CircuitMonkey/mos-kim1-replica/README.md

# mos-kim1-replica
MOS KIM-1 6502 replica project using CHIPz modules.
