CircuitMonkey/mos-kim1-replica/assets/mos-logo.pdf

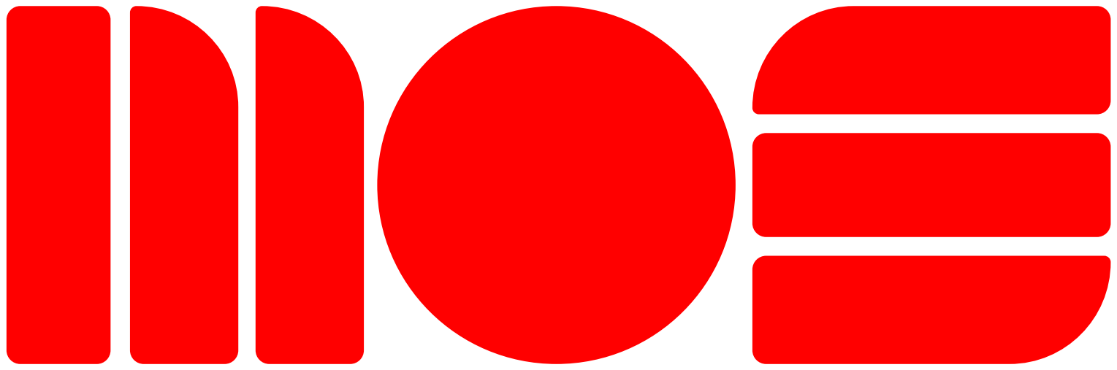
[picture p1: page 1]
