CircuitMonkey/mos-kim1-replica/documents/mainboard/kim-1000-mainboard-rev-a-bom.ods

Reference | Qty | Value | Have | Mouser | MPN | Footprint | Datasheet
C1,C2,C3,C4,C5 | 5 | 0.1uF |  |  |  | Capacitor_SMD:C_0603_1608Metric | ~
D1,D2,D3,D4,D5,D6,D7,D8,D9,D10,D11,D12,D13,D14,D15,D16,D17,D18,D19,D20,D21,D22,D23,D24,D25,D26,D27,D28,D29,D30,D31,D32,D33,D34,D35,D36,D37,D38,D39,D40 | 40 | BLU |  |  |  | LED_SMD:LED_0603_1608Metric | ~
J1 | 1 | Expansion |  |  |  | Connector_Expansion:Expansion
J2 | 1 | Application |  |  |  | Connector_Expansion:Expansion
J3 | 1 | USB_C_Recpt_PO_6P |  |  | UJCHGSMT2P6 | Connector_USB:USB_C_Receptacle_HRO_TYPE-C-31-M-17 | https://www.usb.org/sites/default/files/documents/usb_type-c.zip
R1,R2,R3,R4,R5,R6,R7,R8,R9,R10,R11,R12,R13,R14,R15,R16,R17,R18,R19,R20,R21,R22,R23,R24,R25,R26,R27,R28,R29,R30,R31,R32,R33,R34,R35,R36,R37,R38,R39,R40 | 40 | 100 |  |  |  | Resistor_SMD:R_0603_1608Metric | ~
R50 | 1 | 10K |  |  |  | Resistor_SMD:R_0603_1608Metric | ~
R51,R52 | 2 | 5.1K |  |  |  | Resistor_SMD:R_0603_1608Metric | ~
U1 | 1 | 65C816 |  |  |  | CM_CHIPz_Modules:CPU_65C816_Module
U2 | 1 | Control |  |  |  | CM_CHIPz_Modules:KIM1-Control-CHIPz-Module
U3 | 1 | Keyboard & Display |  |  |  | CM_CHIPz_Modules:KIM1-Kbd-Display-Module
U4,U5 | 2 | 6530 RIOT |  |  |  | CM_CHIPz_Modules:IO_6530_RIOT
U6 | 1 | SRAM 32Kx8 |  |  |  | CM_CHIPz_Modules:KIM1-CHIPz-SRAM-32Kx8
U7,U10,U11,U12 | 4 | 74LV540 |  |  | SN74LV540ARGY | CM_Chip_Packages:TI_RGY0020A-VQFN-20-Pad_3.5x4.5mm | http://www.ti.com/lit/gpn/sn74LS540
U13 | 1 | 74LV541 |  |  | SN74LV541ARKS | CM_Chip_Packages:TI_RKS0020B-VQFN-20-Pad_2.5x4.5mm | http://www.ti.com/lit/gpn/sn74LS541
U14 | 1 | #0131 |  |  |  | CM_CHIPz_Modules:0131-DC-DC-3A
