CircuitMonkey/mos-kim1-replica/documents/control-module/control-logic-module-bom.ods

MOS-KIM-1000 Control Module |  |  | Rev. A
Reference | Qty | Value | Footprint | Have | Datasheet
C1,C6,C7 | 3 | 0.1uF | Capacitor_SMD:C_0603_1608Metric |  | ~
C2 | 1 | 4.7uF | Capacitor_SMD:C_0603_1608Metric |  | ~
C3 | 1 | 0.01uF | Capacitor_SMD:C_0603_1608Metric |  | ~
C4,C5 | 2 | 0.22uF | Capacitor_SMD:C_0603_1608Metric | Mouser | ~
R1,R2,R3,R4,R5,R8,R9,R10,R11 | 9 | 3.3K | Resistor_SMD:R_0603_1608Metric |  | ~
R6,R7 | 2 | 1K | Resistor_SMD:R_0603_1608Metric |  | ~
R12,R13 | 2 | 47K | Resistor_SMD:R_0603_1608Metric |  | ~
U1 | 1 | 74HC04 | CM_Chip_Packages:QFN-14_EP_2.5x3_Pitch0.5mm | Mouser | https://assets.nexperia.com/documents/data-sheet/74HC_HCT04.pdf
U2,U3 | 2 | 74AHC1G00 | Package_TO_SOT_SMD:SOT-353_SC-70-5 | Mouser | http://www.ti.com/lit/sg/scyt129e/scyt129e.pdf
U4 | 1 | TLC556 | Package_SO:SO-14_3.9x8.65mm_P1.27mm | Mouser | https://www.ti.com/lit/ds/symlink/tlc556.pdf?ts=1752791576303
U5 | 1 | 74LS145 | Package_SO:SO-16_3.9x9.9mm_P1.27mm | Mouser | http://www.ti.com/lit/gpn/sn74LS145
Y1 | 1 | 8MHz | Oscillator:Oscillator_SMD_Abracon_ASDMB-4Pin_2.5x2.0mm | Mouser | https://abracon.com/Oscillators/ASDMB.pdf
