CircuitMonkey/mos-kim1-replica/documents/kbd-display-module/kbd-display-module-bom.ods

MOS KIM-1000 Keyboard&Display |  |  |  | Rev. A
Reference | Qty | Value | Have | Footprint | Datasheet
C1,C2 | 2 | 0.1uF |  | Capacitor_SMD:C_0603_1608Metric | ~
D1 | 1 | BLUE |  | LED_SMD:LED_0603_1608Metric | ~
Q1,Q2,Q3,Q4,Q5,Q6 | 6 | MMBT3906 | Mouser | Package_TO_SOT_SMD:SOT-23 | https://www.onsemi.com/pdf/datasheet/pzt3906-d.pdf
R1,R2,R3,R4,R5,R6 | 6 | 470 |  | Resistor_SMD:R_0603_1608Metric | ~
R7,R8,R9,R10,R11,R12 | 6 | 100K |  | Resistor_SMD:R_0603_1608Metric | ~
R13,R14,R15,R16,R17,R18,R19,R20 | 8 | 100 |  | Resistor_SMD:R_0603_1608Metric | ~
SW1 | 1 | BTN_0 | Zodiac | CM_Switches:Tactile_CK_KSC_6x6_Gullwing | https://www.taydaelectronics.com/tact-switch-6-3-6-6mm-3-1mm-smd-spst-no.html
SW2 | 1 | BTN_1 |  | CM_Switches:Tactile_CK_KSC_6x6_Gullwing | https://www.taydaelectronics.com/tact-switch-6-3-6-6mm-3-1mm-smd-spst-no.html
SW3 | 1 | BTN_2 |  | CM_Switches:Tactile_CK_KSC_6x6_Gullwing | https://www.taydaelectronics.com/tact-switch-6-3-6-6mm-3-1mm-smd-spst-no.html
SW4 | 1 | BTN_3 |  | CM_Switches:Tactile_CK_KSC_6x6_Gullwing | https://www.taydaelectronics.com/tact-switch-6-3-6-6mm-3-1mm-smd-spst-no.html
SW5 | 1 | BTN_4 |  | CM_Switches:Tactile_CK_KSC_6x6_Gullwing | https://www.taydaelectronics.com/tact-switch-6-3-6-6mm-3-1mm-smd-spst-no.html
SW6 | 1 | BTN_5 |  | CM_Switches:Tactile_CK_KSC_6x6_Gullwing | https://www.taydaelectronics.com/tact-switch-6-3-6-6mm-3-1mm-smd-spst-no.html
SW7 | 1 | BTN_6 |  | CM_Switches:Tactile_CK_KSC_6x6_Gullwing | https://www.taydaelectronics.com/tact-switch-6-3-6-6mm-3-1mm-smd-spst-no.html
SW8 | 1 | BTN_7 |  | CM_Switches:Tactile_CK_KSC_6x6_Gullwing | https://www.taydaelectronics.com/tact-switch-6-3-6-6mm-3-1mm-smd-spst-no.html
SW9 | 1 | BTN_8 |  | CM_Switches:Tactile_CK_KSC_6x6_Gullwing | https://www.taydaelectronics.com/tact-switch-6-3-6-6mm-3-1mm-smd-spst-no.html
SW10 | 1 | BTN_9 |  | CM_Switches:Tactile_CK_KSC_6x6_Gullwing | https://www.taydaelectronics.com/tact-switch-6-3-6-6mm-3-1mm-smd-spst-no.html
SW11 | 1 | BTN_A |  | CM_Switches:Tactile_CK_KSC_6x6_Gullwing | https://www.taydaelectronics.com/tact-switch-6-3-6-6mm-3-1mm-smd-spst-no.html
SW12 | 1 | BTN_B |  | CM_Switches:Tactile_CK_KSC_6x6_Gullwing | https://www.taydaelectronics.com/tact-switch-6-3-6-6mm-3-1mm-smd-spst-no.html
SW13 | 1 | BTN_C |  | CM_Switches:Tactile_CK_KSC_6x6_Gullwing | https://www.taydaelectronics.com/tact-switch-6-3-6-6mm-3-1mm-smd-spst-no.html
SW14 | 1 | BTN_D |  | CM_Switches:Tactile_CK_KSC_6x6_Gullwing | https://www.taydaelectronics.com/tact-switch-6-3-6-6mm-3-1mm-smd-spst-no.html
SW15 | 1 | BTN_E |  | CM_Switches:Tactile_CK_KSC_6x6_Gullwing | https://www.taydaelectronics.com/tact-switch-6-3-6-6mm-3-1mm-smd-spst-no.html
SW16 | 1 | BTN_F |  | CM_Switches:Tactile_CK_KSC_6x6_Gullwing | https://www.taydaelectronics.com/tact-switch-6-3-6-6mm-3-1mm-smd-spst-no.html
SW17 | 1 | BTN_AD |  | CM_Switches:Tactile_CK_KSC_6x6_Gullwing | https://www.taydaelectronics.com/tact-switch-6-3-6-6mm-3-1mm-smd-spst-no.html
SW18 | 1 | BTN_DA |  | CM_Switches:Tactile_CK_KSC_6x6_Gullwing | https://www.taydaelectronics.com/tact-switch-6-3-6-6mm-3-1mm-smd-spst-no.html
SW19 | 1 | BTN_PLUS |  | CM_Switches:Tactile_CK_KSC_6x6_Gullwing | https://www.taydaelectronics.com/tact-switch-6-3-6-6mm-3-1mm-smd-spst-no.html
SW20 | 1 | BTN_GO |  | CM_Switches:Tactile_CK_KSC_6x6_Gullwing | https://www.taydaelectronics.com/tact-switch-6-3-6-6mm-3-1mm-smd-spst-no.html
SW21 | 1 | BTN_PC |  | CM_Switches:Tactile_CK_KSC_6x6_Gullwing | https://www.taydaelectronics.com/tact-switch-6-3-6-6mm-3-1mm-smd-spst-no.html
SW22 | 1 | BTN_RS |  | CM_Switches:Tactile_CK_KSC_6x6_Gullwing | https://www.taydaelectronics.com/tact-switch-6-3-6-6mm-3-1mm-smd-spst-no.html
SW23 | 1 | BTN_ST |  | CM_Switches:Tactile_CK_KSC_6x6_Gullwing | https://www.taydaelectronics.com/tact-switch-6-3-6-6mm-3-1mm-smd-spst-no.html
SW24 | 1 | Single-Step | Mouser | CM_Switches:CK_JS202011SC_SLIDE_DPDT_SMT_9x3.6
U1 | 1 | 74HC42 | Mouser | Package_SO:SO-16_3.9x9.9mm_P1.27mm | http://www.ti.com/lit/gpn/sn74HC42
U2 | 1 | Color |  | CM_Display_Character:Avago-HDSM-281x-283x-SevenSeg | https://docs.broadcom.com/doc/HDSM-281x-283x-0-28-in-Single-Digit-SMT-LED-Display-DS
U3,U4,U5,U6,U7 | 5 | BLUE |  | CM_Display_Character:Avago-HDSM-281x-283x-SevenSeg | https://docs.broadcom.com/doc/HDSM-281x-283x-0-28-in-Single-Digit-SMT-LED-Display-DS
U8 | 1 | 74LVC06 | Mouser | Package_SO:SOIC-14_3.9x8.7mm_P1.27mm | https://assets.nexperia.com/documents/data-sheet/74LVC06A.pdf
U9 | 1 | 74LVC1G06Z | Mouser | CM_Chip_Packages:SOT-353 | http://www.ti.com/lit/sg/scyt129e/scyt129e.pdf
