CircuitMonkey/mos-kim1-replica/documents/sram-module/sram-32kx8-module-bom.ods

KIM-1000 SRAM Module |  |  | Rev. A
Reference | Qty | Value | Footprint | Have | Datasheet
C1,C2 | 2 | 0.1uF | Capacitor_SMD:C_0603_1608Metric |  | ~
U1 | 1 | 74LV20 | Package_SO:SOIC-14_3.9x8.7mm_P1.27mm | Mouser | http://www.ti.com/lit/gpn/sn74LS20
U2 | 1 | 74AHC1G00 | Package_TO_SOT_SMD:SOT-353_SC-70-5 | Mouser | http://www.ti.com/lit/sg/scyt129e/scyt129e.pdf
U3 | 1 | 62LV256AL45ULI | CM_Chip_Packages:SOIC-28_18x9 | Mouser | https://www.mouser.com/datasheet/2/198/62_65LV256AL-258445.pdf
