CircuitMonkey/mos-kim1-replica/pcb/sram-32kx8-module/sram-32kx8-module.step

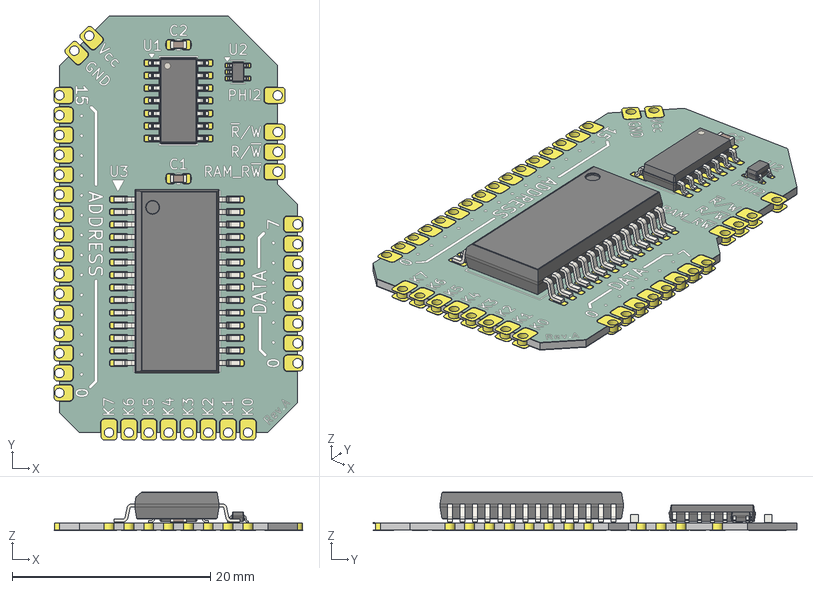
[picture p2: CAD file, 2025-07-27]
pcb/sram-32kx8-module/sram-32kx8-module.step
25.1 x 42.8 x 3.92 mm
SOT-353_SC-70-5
SOIC-14_3.9x8.7mm_P1.27mm
sop-28-330mil
C_0603_1608Metric x 2
sram-32kx8-module_copper
sram-32kx8-module_silkscreen
sram-32kx8-module_soldermask
sram-32kx8-module_PCB
