CircuitMonkey/mos-kim1-replica/documents/mainboard/kim-1000-mainboard-rev-a-schematic.pdf

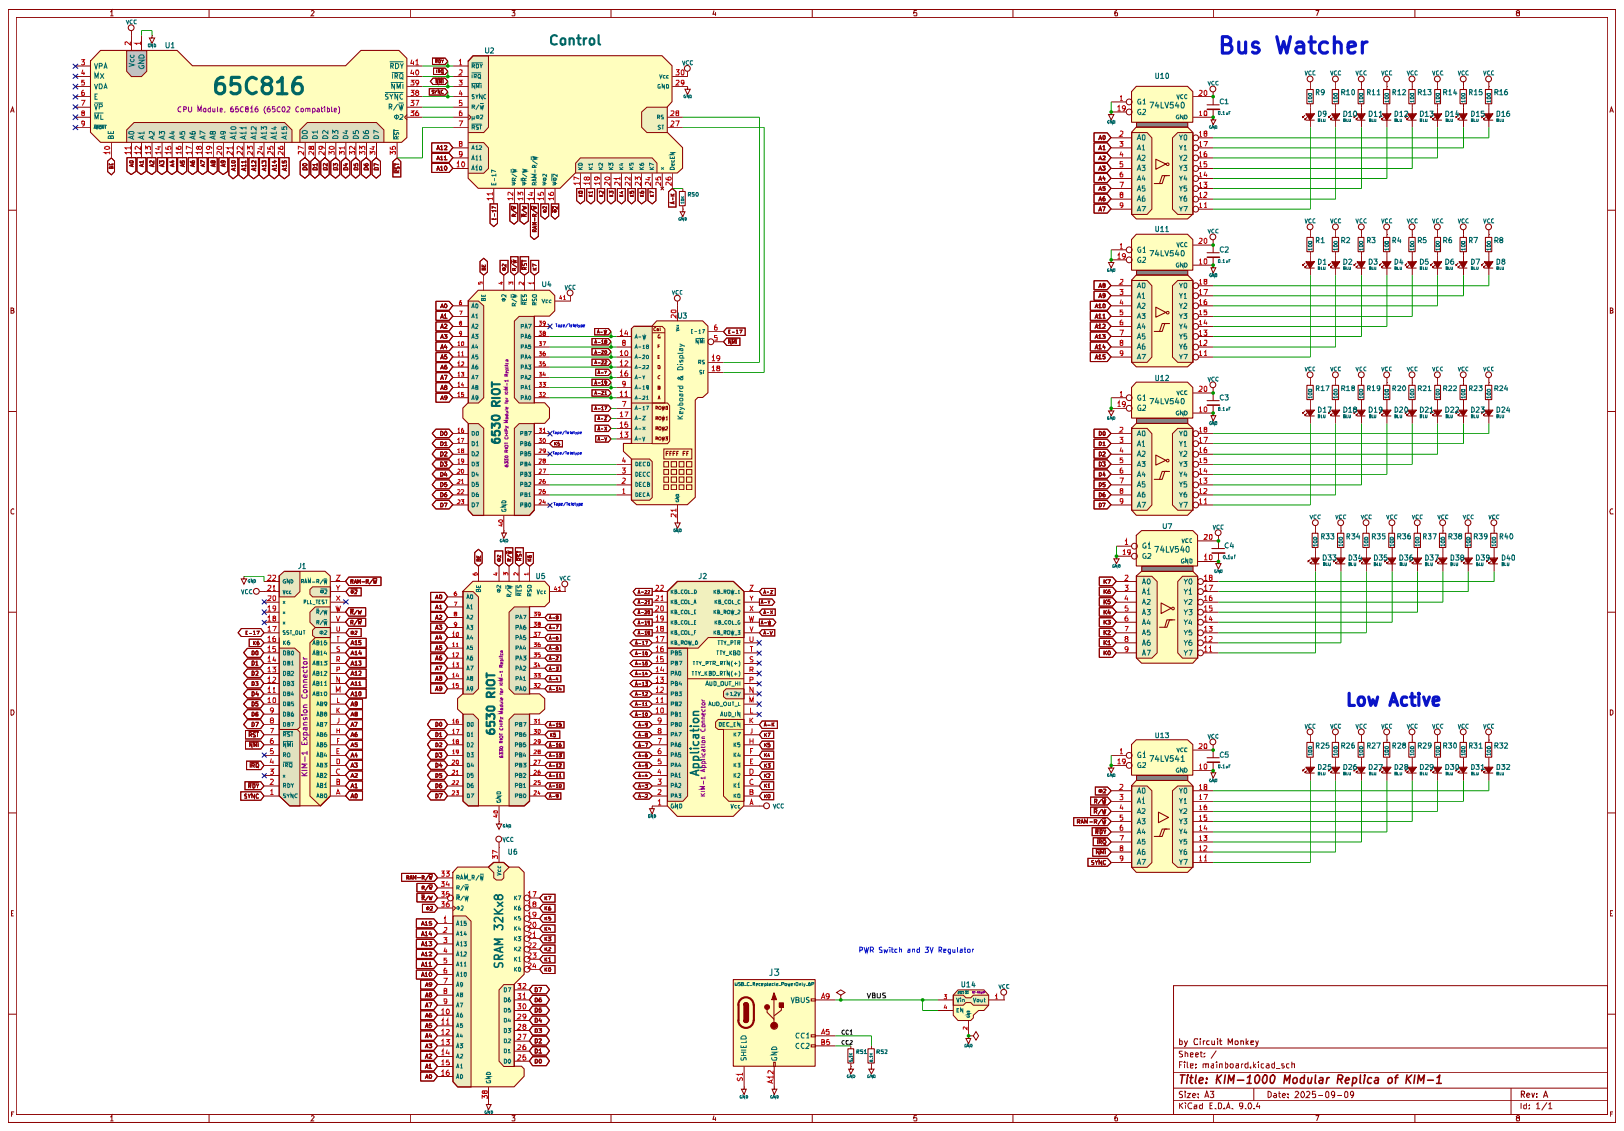
[picture p3: page 1]
