CircuitMonkey/mos-kim1-replica/documents/control-module/control-logic-module-rev-b-sch.pdf

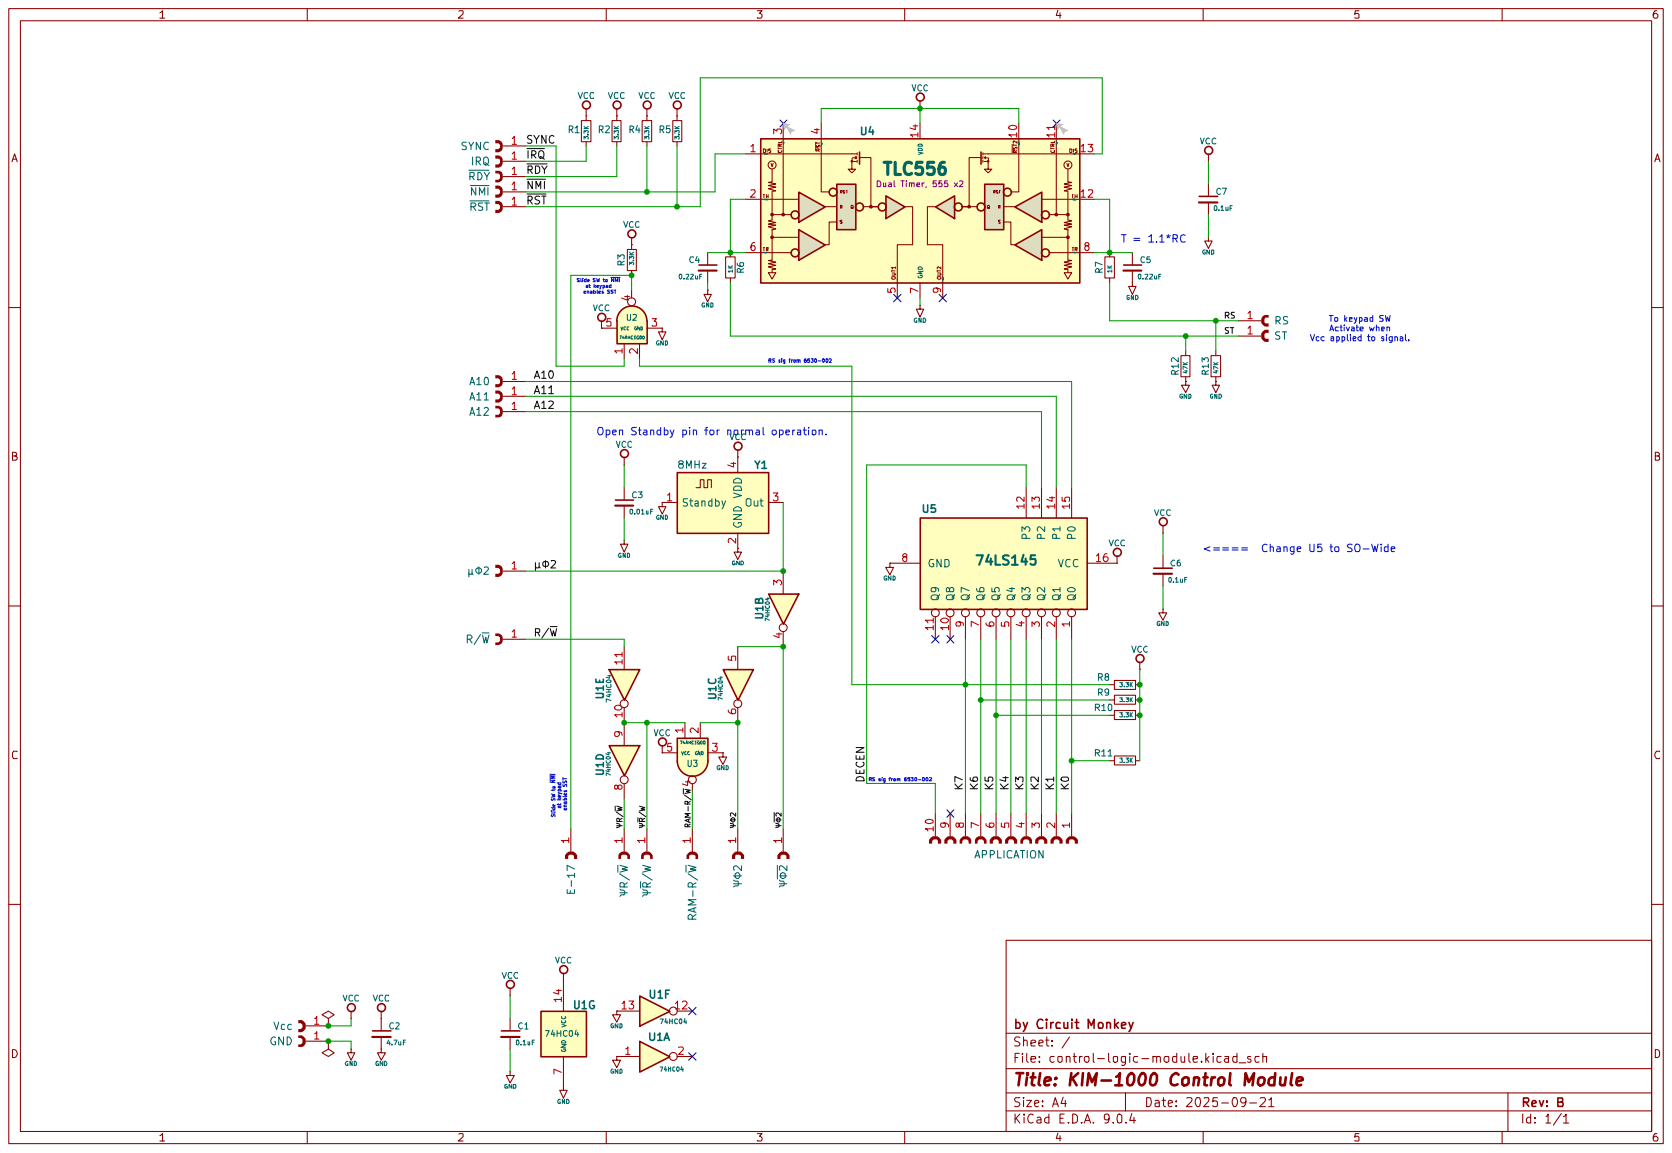
[picture p4: page 1]
