CircuitMonkey/mos-kim1-replica/documents/sram-module/sram-32kx8-module-sch.pdf

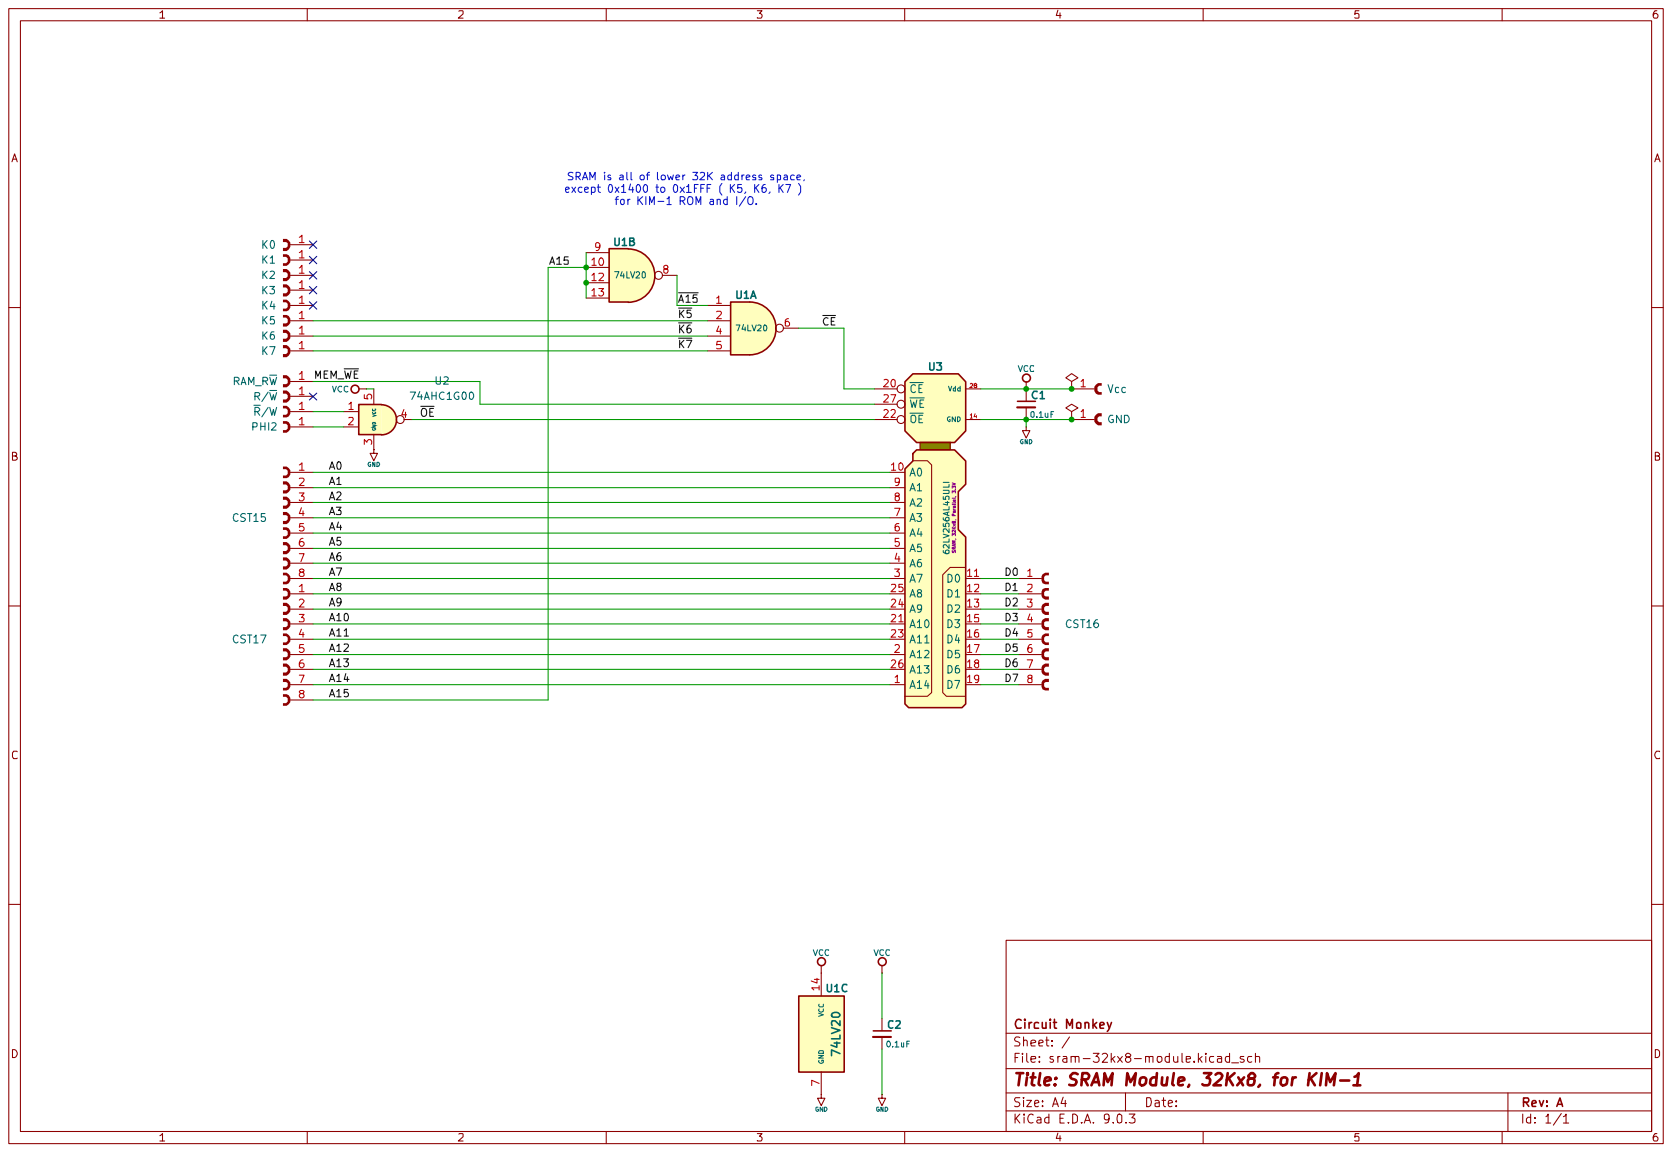
[picture p5: page 1]
