CircuitMonkey/mos-kim1-replica/documents/control-module/control-logic-module-sch.pdf

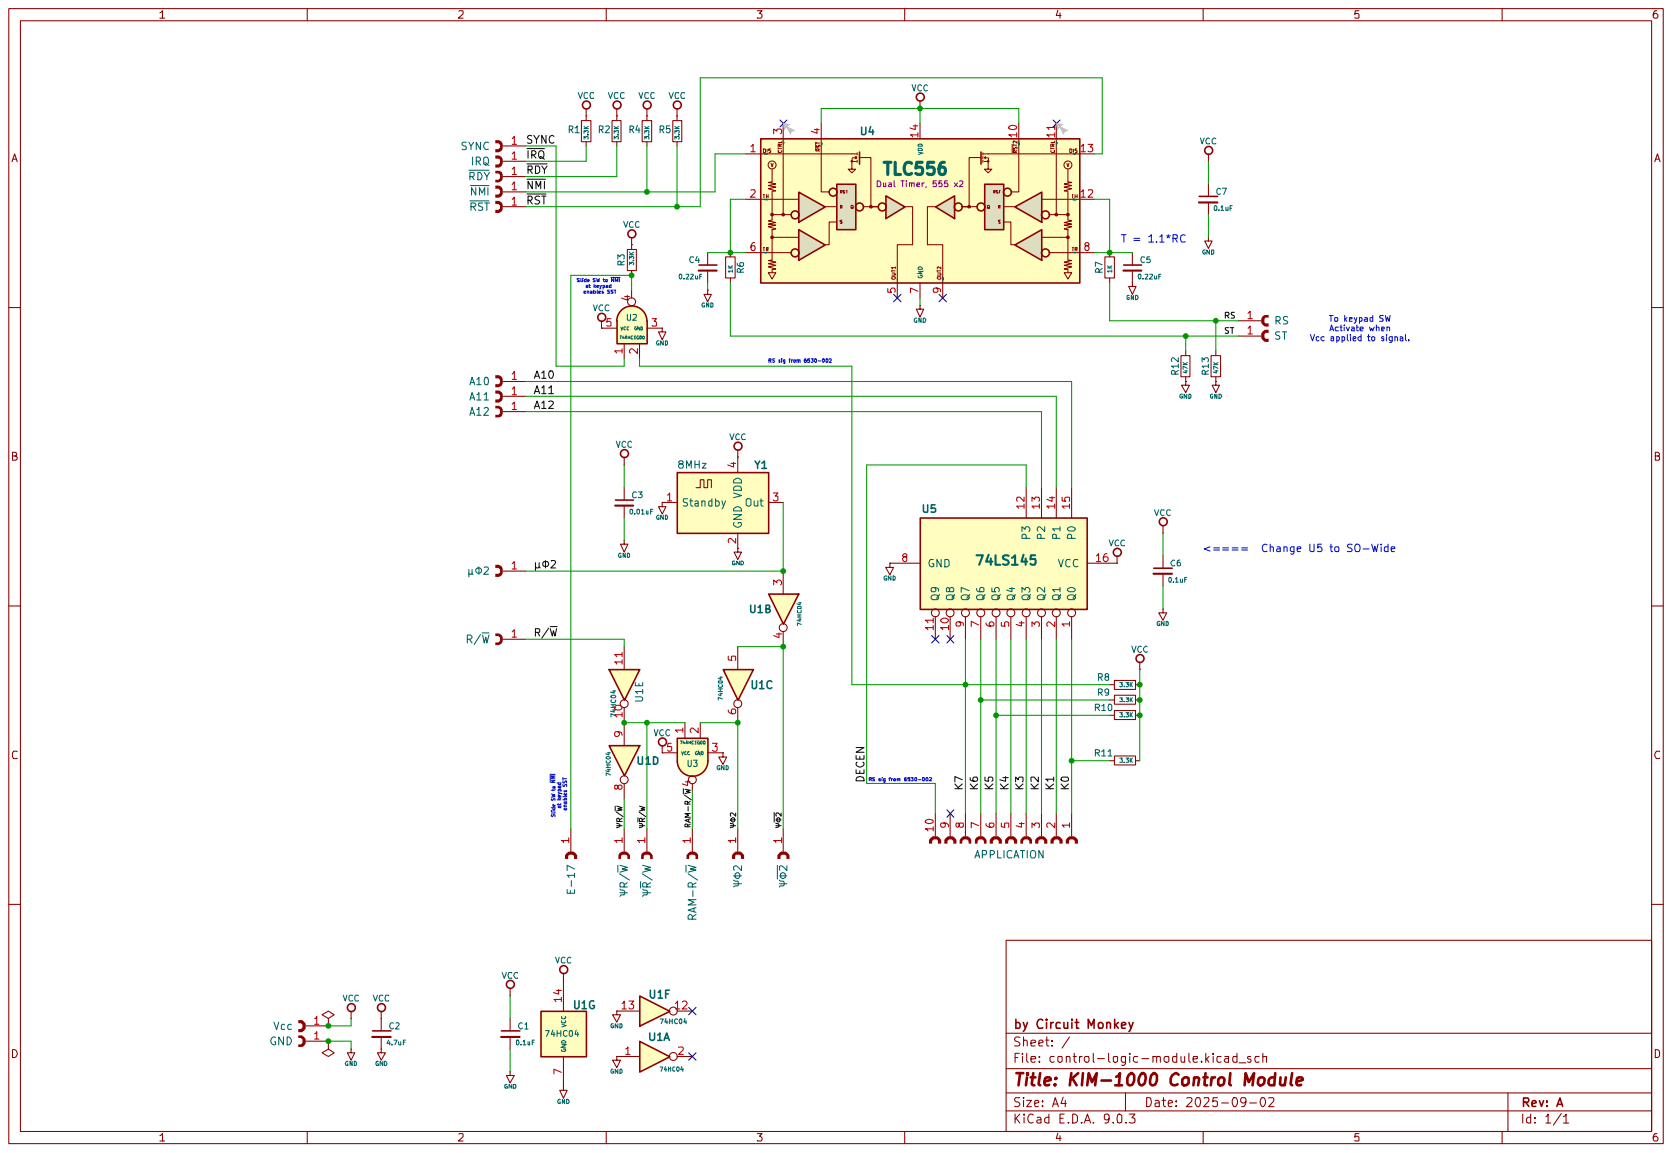
[picture p6: page 1]
