CircuitMonkey/mos-kim1-replica/pcb/control-logic-module/control-logic-module.kicad_pcb

## KiCad design pcb/control-logic-module/control-logic-module.kicad_pcb (2025-09-22)

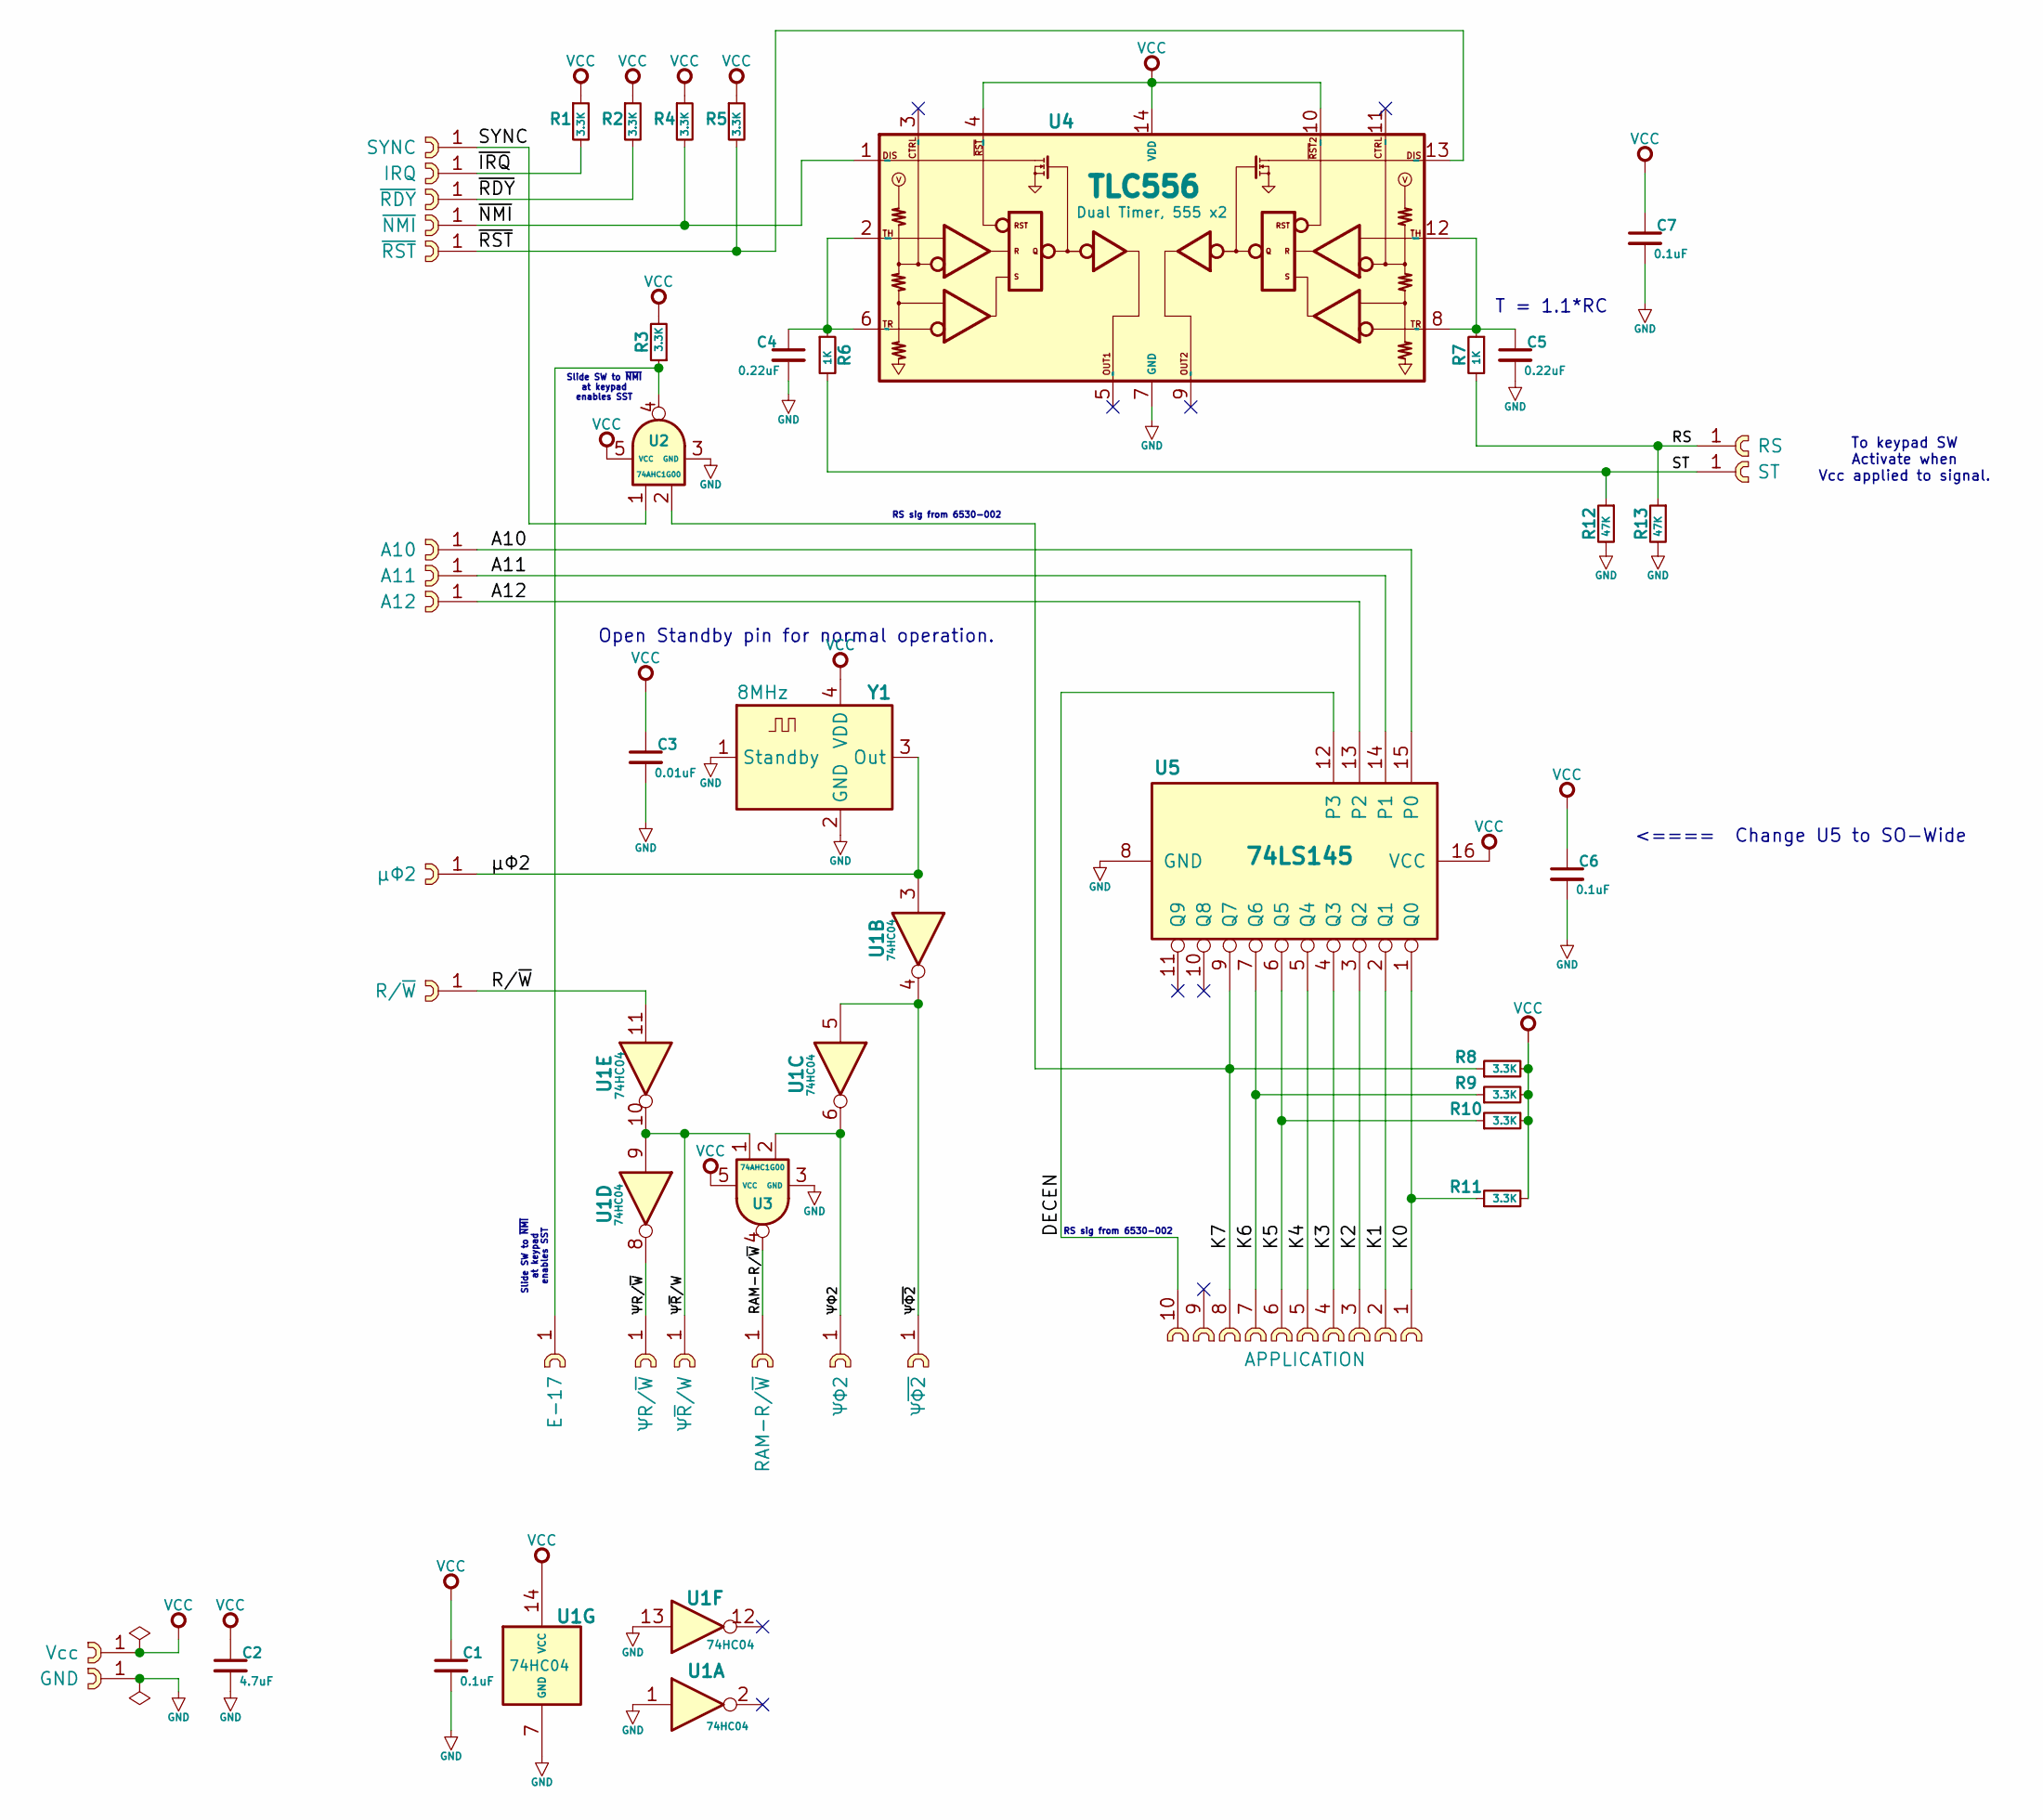
[picture p7: schematic control-logic-module.kicad_sch, KIM-1000 Control Module]

Parts:
C1, C6, C7: 0.1uF; C_0603_1608Metric
C2: 4.7uF; C_0603_1608Metric
C3: 0.01uF; C_0603_1608Metric
C4, C5: 0.22uF; C_0603_1608Metric
CST1: Vcc; cast-2.0-01P
CST2: GND; cast-2.0-01P
CST3: SYNC; cast-2.0-01P
CST4: IRQ; cast-2.0-01P
CST5: ~{RDY}; cast-2.0-01P
CST6: ~{NMI}; cast-2.0-01P
CST7: ~{RST}; cast-2.0-01P
CST8: A10; cast-2.0-01P
CST9: A11; cast-2.0-01P
CST10: A12; cast-2.0-01P
CST11: μΦ2; cast-2.0-01P
CST12: R/~{W}; cast-2.0-01P
CST13: E-17; cast-2.0-01P
CST14: ΨR/~{W}; cast-2.0-01P
CST15: Ψ~{R}/W; cast-2.0-01P
CST16: RAM-R/~{W}; cast-2.0-01P
CST17: ΨΦ2; cast-2.0-01P
CST18: Ψ~{Φ2}; cast-2.0-01P
CST19: APPLICATION; cast-2.0-10P
CST20: RS; cast-2.0-01P
CST21: ST; cast-2.0-01P
R1, R2, R3, R4, R5, R8, R9, R10, R11: 3.3K; R_0603_1608Metric
R6, R7: 1K; R_0603_1608Metric
R12, R13: 47K; R_0603_1608Metric
U1: 74HC04; QFN-14_EP_2.5x3_Pitch0.5mm
U2, U3: 74AHC1G00; SOT-353_SC-70-5; MPN MC74HC1G00DFT1G
U4: TLC556; SO-14_3.9x8.65mm_P1.27mm
U5: 74LS145; SO-16_3.9x9.9mm_P1.27mm
Y1: 8MHz; Oscillator_SMD_Abracon_ASDMB-4Pin_2.5x2.0mm; MPN ASD-8.000MHZ-LC-T

Connections:
/A10: CST8.1, U5.15 (P0)
/A11: CST9.1, U5.14 (P1)
/A12: CST10.1, U5.13 (P2)
/DECEN: CST19.10, U5.12 (P3)
/K0: CST19.1, R11.1, U5.1 (Q0)
/K1: CST19.2, U5.2 (Q1)
/K2: CST19.3, U5.3 (Q2)
/K3: CST19.4, U5.4 (Q3)
/K4: CST19.5, U5.5 (Q4)
/K5: CST19.6, R10.1, U5.6 (Q5)
/K6: CST19.7, R9.1, U5.7 (Q6)
/K7: CST19.8, R8.1, U2.2, U5.9 (Q7)
/RAM-R/~W: CST16.1, U3.4
/RS: CST20.1, R7.2, R13.1
/R/~W: CST12.1, U1.11
/ST: CST21.1, R6.2, R12.1
/SYNC: CST3.1, U2.1
/~IRQ: CST4.1, R1.2
/~NMI: CST6.1, R4.2, U4.1 (DISCH1)
/~RDY: CST5.1, R2.2
/~RST: CST7.1, R5.2, U4.13 (DISCH2)
/ΨR/~W: CST14.1, U1.8
/Ψ~R/W: CST15.1, U1.9, U1.10, U3.1
/Ψ~Φ2: CST18.1, U1.4, U1.5
/ΨΦ2: CST17.1, U1.6, U3.2
/μΦ2: CST11.1, U1.3, Y1.3 (Out)
GND: C1.2, C2.2, C3.2, C4.2, C5.2, C6.2, C7.2, CST2.1, R12.2, R13.2, U1.1, U1.7 (GND), U1.13, U2.3 (GND), U3.3 (GND), U4.7 (GND), U5.8 (GND), Y1.1 (Standby), Y1.2 (GND)
unnamed: CST13.1, R3.1, U2.4
unnamed: C4.1, R6.1, U4.2 (THRESH1), U4.6 (TRIG1)
unnamed: C5.1, R7.1, U4.8 (TRIG2), U4.12 (THRESH2)
VCC: C1.1, C2.1, C3.1, C6.1, C7.1, CST1.1, R1.1, R2.1, R3.2, R4.1, R5.1, R8.2, R9.2, R10.2, R11.2, U1.14 (VCC), U2.5 (VCC), U3.5 (VCC), U4.4 (RESET1), U4.10 (RESET2), U4.14 (VDD), U5.16 (VCC), Y1.4 (VDD)

Notes on the sheet:
RS sig from 6530-002
Slide SW to ~{NMI} at keypad enables SST
T = 1.1*RC
Open Standby pin for normal operation.
To keypad SW Activate when Vcc applied to signal.
<==== Change U5 to SO-Wide

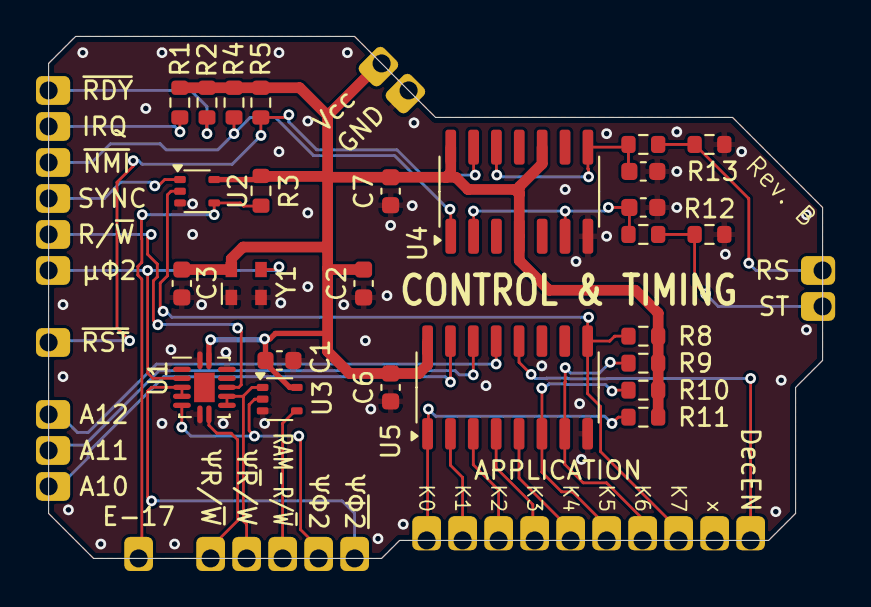
[picture p8: board control-logic-module.kicad_pcb from above]

Board: 2 copper layers, 43.0 x 29.0 mm, 47 parts (0 on the bottom side), 31 nets.
