CircuitMonkey/mos-kim1-replica/pcb/mainboard/mainboard.kicad_pcb

## KiCad design pcb/mainboard/mainboard.kicad_pcb (2025-09-09)

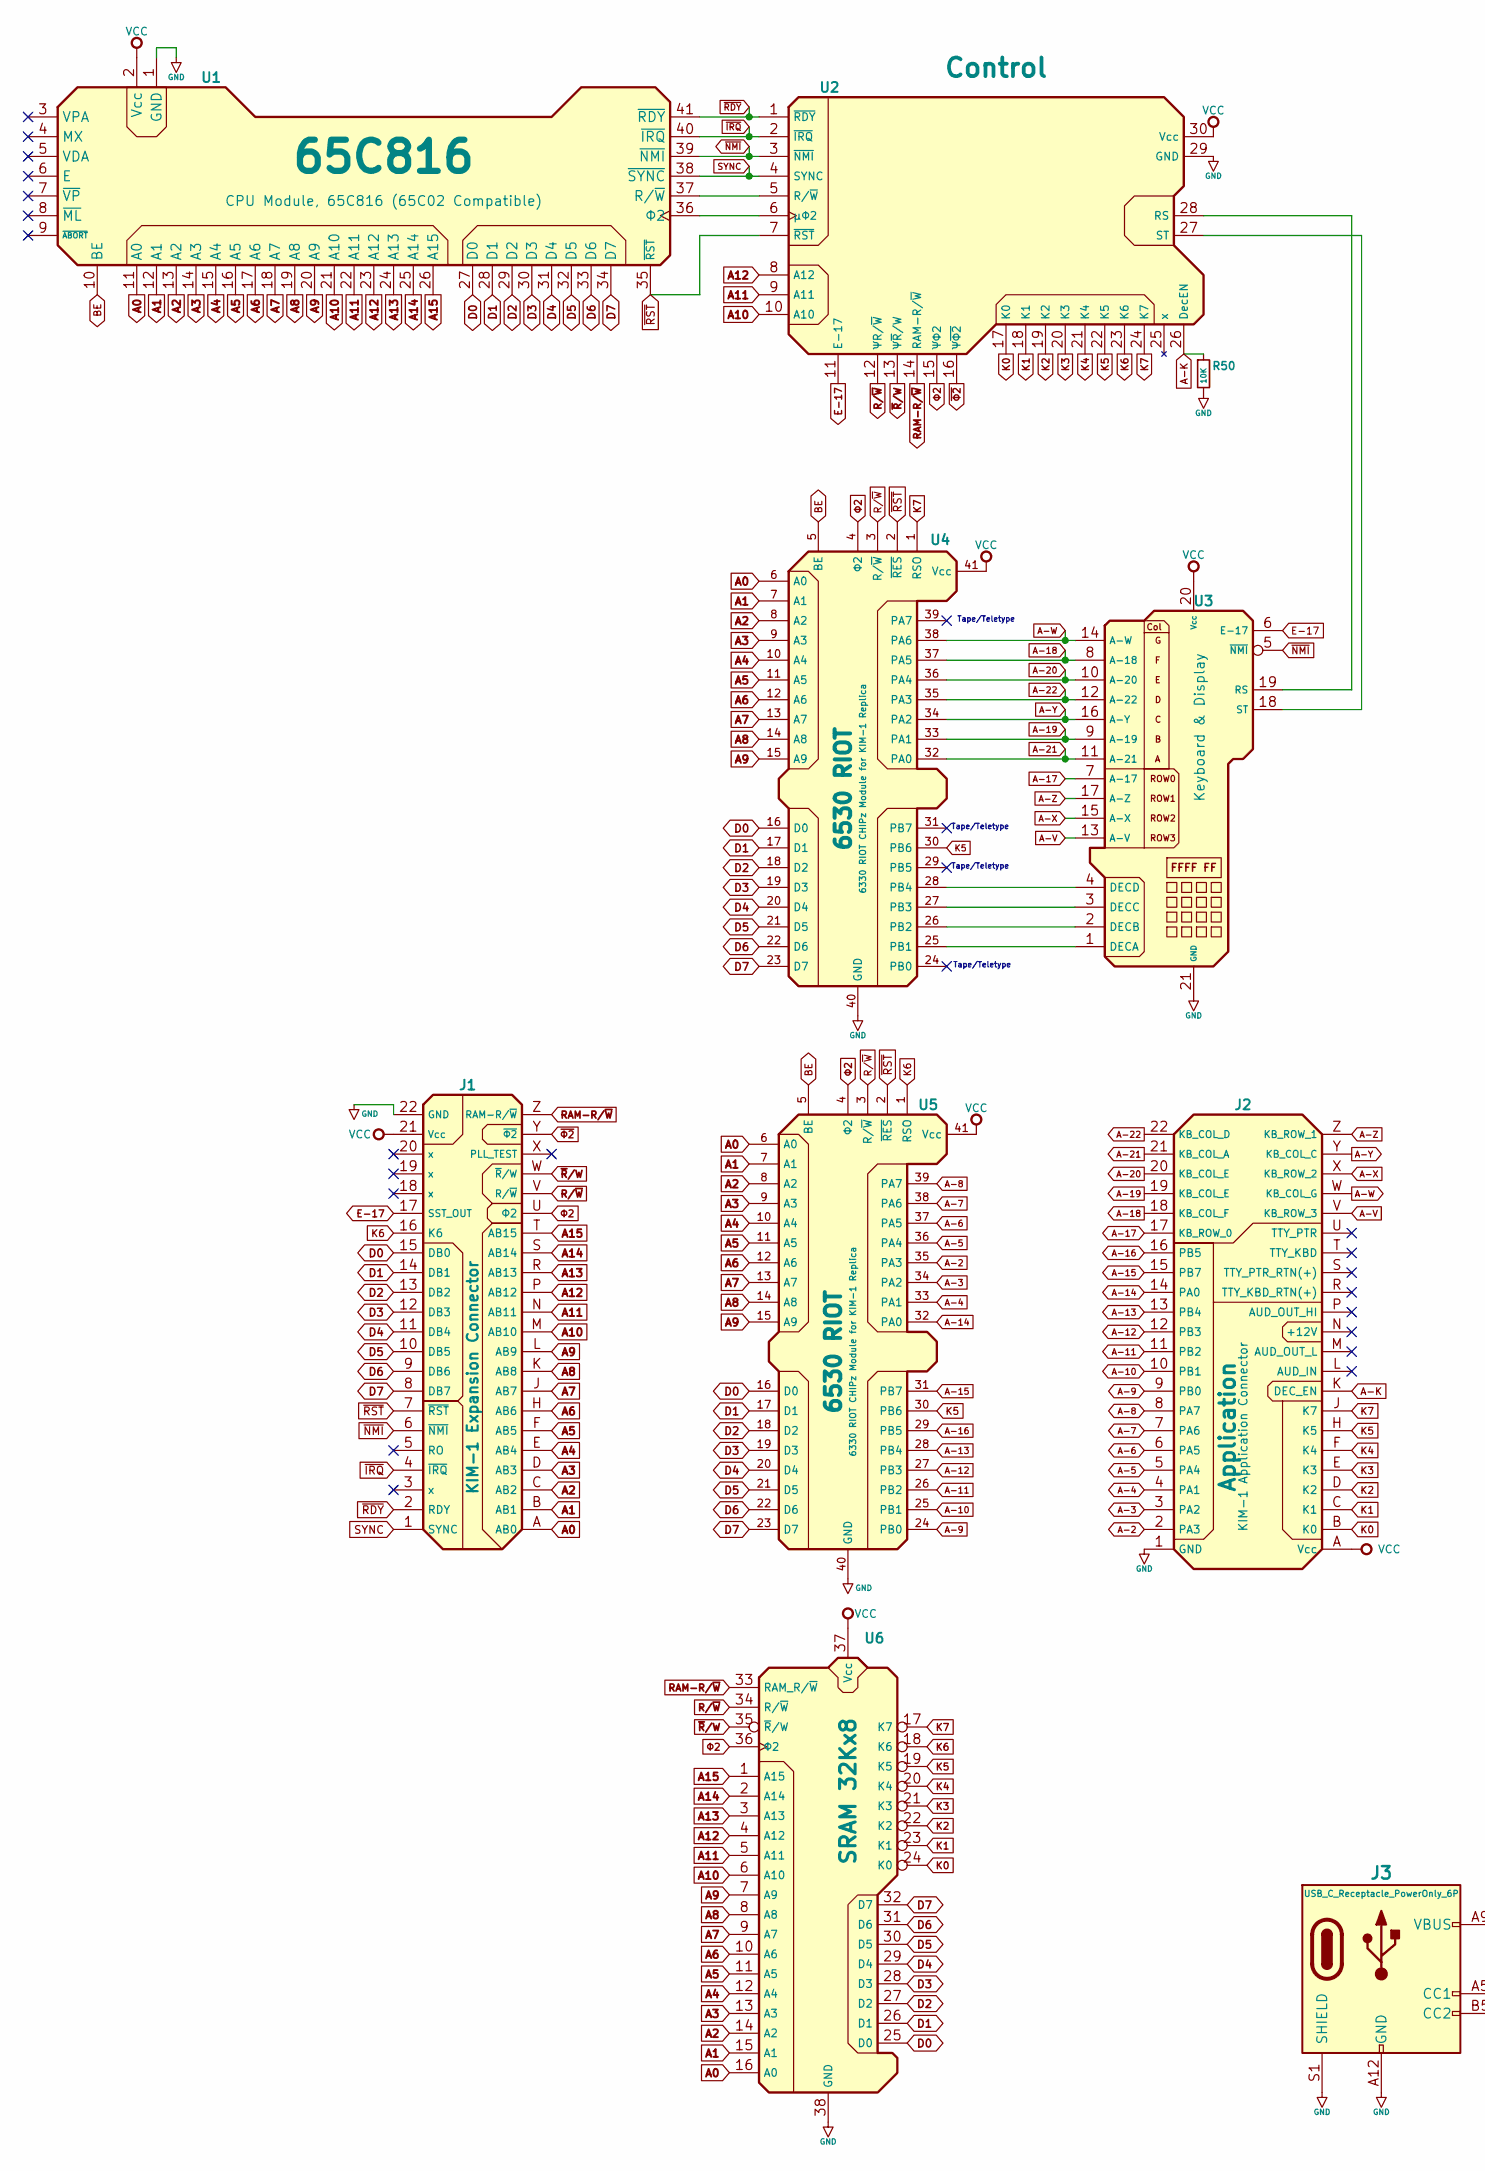
[picture p9: schematic mainboard.kicad_sch, KIM-1000 Modular Replica of KIM-1, part in row 1, column 1]

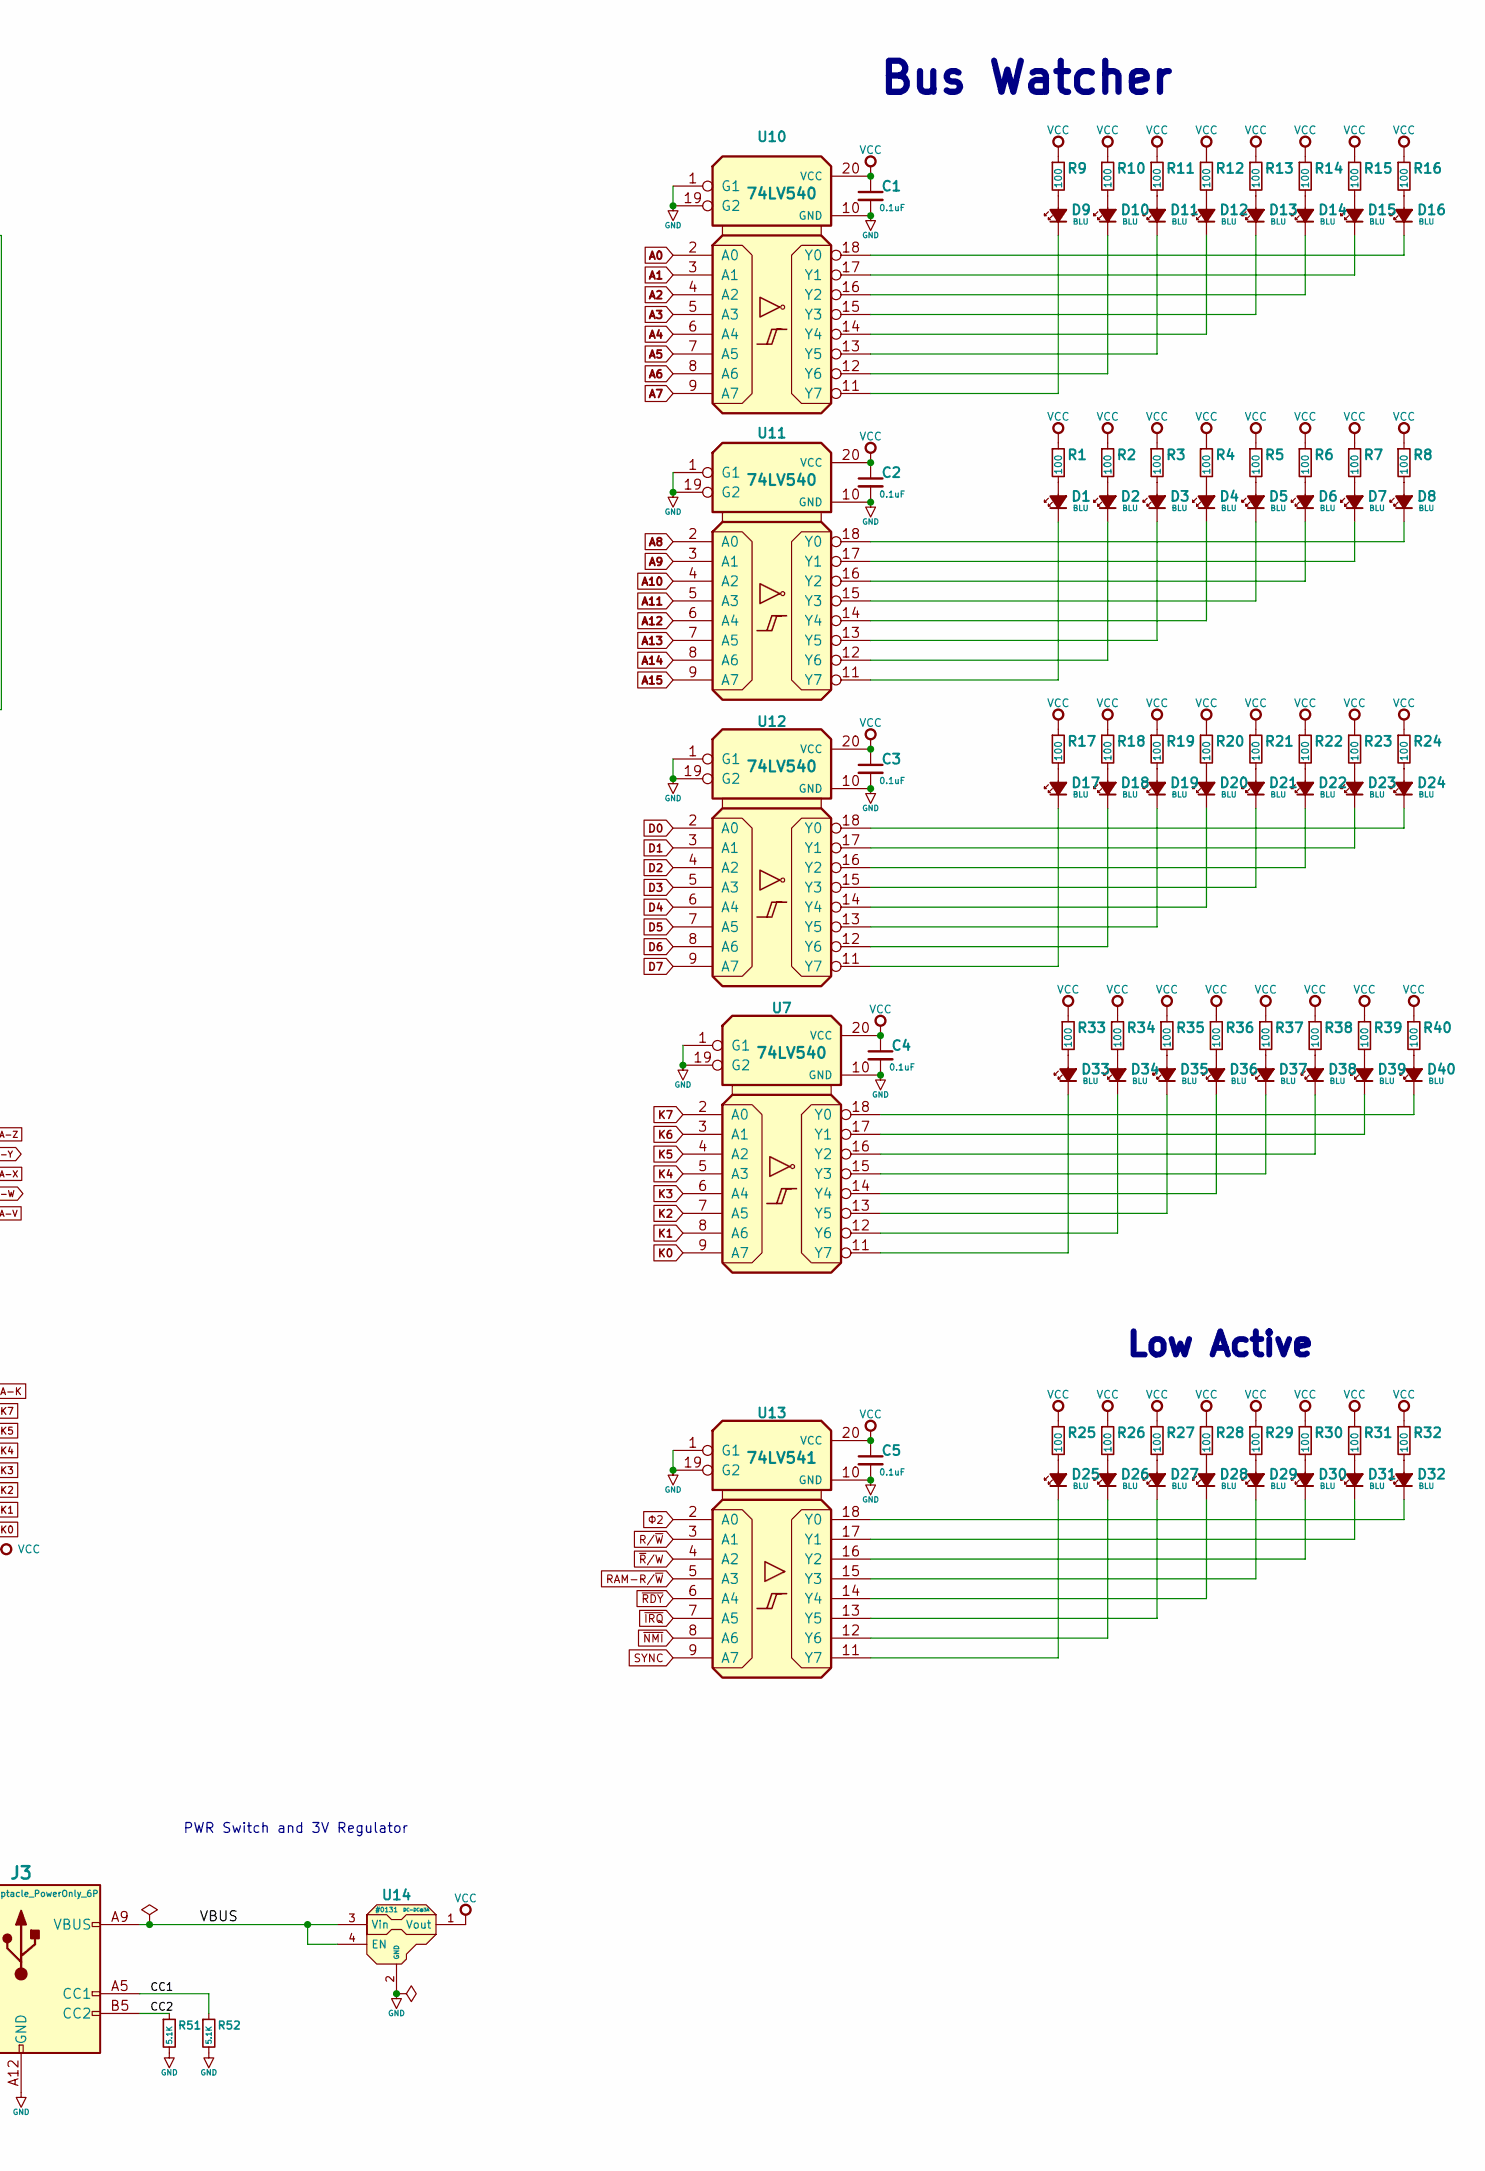
[picture p10: schematic mainboard.kicad_sch, KIM-1000 Modular Replica of KIM-1, part in row 1, column 2]

Parts:
C1, C2, C3, C4, C5: 0.1uF; C_0603_1608Metric
D1, D2, D3, D4, D5, D6, D7, D8, D9, D10, D11, D12, D13, D14, D15, D16, D17, D18, D19, D20, D21, D22, D23, D24, D25, D26, D27, D28, D29, D30, D31, D32, D33, D34, D35, D36, D37, D38, D39, D40: BLU; LED_0603_1608Metric
J1: Expansion
J2: Application; Expansion
J3: USB_C_Receptacle_PowerOnly_6P; USB_C_Receptacle_HRO_TYPE-C-31-M-17
R1, R2, R3, R4, R5, R6, R7, R8, R9, R10, R11, R12, R13, R14, R15, R16, R17, R18, R19, R20, R21, R22, R23, R24, R25, R26, R27, R28, R29, R30, R31, R32, R33, R34, R35, R36, R37, R38, R39, R40: 100; R_0603_1608Metric
R50: 10K; R_0603_1608Metric
R51, R52: 5.1K; R_0603_1608Metric
U1: 65C816; CPU_65C816_Module
U2: Control; KIM1-Control-CHIPz-Module
U3: Keyboard & Display; KIM1-Kbd-Display-Module
U4, U5: 6530 RIOT; IO_6530_RIOT
U6: SRAM 32Kx8; KIM1-CHIPz-SRAM-32Kx8
U7, U10, U11, U12: 74LV540; TI_RGY0020A-VQFN-20-Pad_3.5x4.5mm; MPN SN74LV540ARGY
U13: 74LV541; TI_RKS0020B-VQFN-20-Pad_2.5x4.5mm; MPN SN74LV540ARGY
U14: #0131; 0131-DC-DC-3A

Connections:
/CC1: J3.A5 (CC1), R52.1
/CC2: J3.B5 (CC2), R51.1
/VBUS: J3.A9 (VBUS), J3.B9 (VBUS), U14.3 (Vin), U14.4 (EN)
A0: J1.A (AB0), U1.11 (A0), U4.6 (A0), U5.6 (A0), U6.16 (A0), U10.2 (A0)
A1: J1.B (AB1), U1.12 (A1), U4.7 (A1), U5.7 (A1), U6.15 (A1), U10.3 (A1)
A2: J1.C (AB2), U1.13 (A2), U4.8 (A2), U5.8 (A2), U6.14 (A2), U10.4 (A2)
A3: J1.D (AB3), U1.14 (A3), U4.9 (A3), U5.9 (A3), U6.13 (A3), U10.5 (A3)
A4: J1.E (AB4), U1.15 (A4), U4.10 (A4), U5.10 (A4), U6.12 (A4), U10.6 (A4)
A5: J1.F (AB5), U1.16 (A5), U4.11 (A5), U5.11 (A5), U6.11 (A5), U10.7 (A5)
A6: J1.H (AB6), U1.17 (A6), U4.12 (A6), U5.12 (A6), U6.10 (A6), U10.8 (A6)
A7: J1.J (AB7), U1.18 (A7), U4.13 (A7), U5.13 (A7), U6.9 (A7), U10.9 (A7)
A8: J1.K (AB8), U1.19 (A8), U4.14 (A8), U5.14 (A8), U6.8 (A8), U11.2 (A0)
A9: J1.L (AB9), U1.20 (A9), U4.15 (A9), U5.15 (A9), U6.7 (A9), U11.3 (A1)
A10: J1.M (AB10), U1.21 (A10), U2.10 (A10), U6.6 (A10), U11.4 (A2)
A11: J1.N (AB11), U1.22 (A11), U2.9 (A11), U6.5 (A11), U11.5 (A3)
A12: J1.P (AB12), U1.23 (A12), U2.8 (A12), U6.4 (A12), U11.6 (A4)
A13: J1.R (AB13), U1.24 (A13), U6.3 (A13), U11.7 (A5)
A14: J1.S (AB14), U1.25 (A14), U6.2 (A14), U11.8 (A6)
A15: J1.T (AB15), U1.26 (A15), U6.1 (A15), U11.9 (A7)
A-2: J2.2 (PA3), U5.35 (PA3)
A-3: J2.3 (PA2), U5.34 (PA2)
A-4: J2.4 (PA1), U5.33 (PA1)
A-5: J2.5 (PA4), U5.36 (PA4)
A-6: J2.6 (PA5), U5.37 (PA5)
A-7: J2.7 (PA6), U5.38 (PA6)
A-8: J2.8 (PA7), U5.39 (PA7)
A-9: J2.9 (PB0), U5.24 (PB0)
A-10: J2.10 (PB1), U5.25 (PB1)
A-11: J2.11 (PB2), U5.26 (PB2)
A-12: J2.12 (PB3), U5.27 (PB3)
A-13: J2.13 (PB4), U5.28 (PB4)
A-14: J2.14 (PA0), U5.32 (PA0)
A-15: J2.15 (PB7), U5.31 (PB7)
A-16: J2.16 (PB5), U5.29 (PB5)
A-17: J2.17 (KB_ROW_0), U3.7 (A-17)
A-18: J2.18 (KB_COL_F), U3.8 (A-18), U4.37 (PA5)
A-19: J2.19 (KB_COL_E), U3.9 (A-19), U4.33 (PA1)
A-20: J2.20 (KB_COL_E), U3.10 (A-20), U4.36 (PA4)
A-21: J2.21 (KB_COL_A), U3.11 (A-21), U4.32 (PA0)
A-22: J2.22 (KB_COL_D), U3.12 (A-22), U4.35 (PA3)
A-K: J2.K (DEC_EN), R50.1, U2.26 (DecEN)
A-V: J2.V (KB_ROW_3), U3.13 (A-V)
A-W: J2.W (KB_COL_G), U3.14 (A-W), U4.38 (PA6)
A-X: J2.X (KB_ROW_2), U3.15 (A-X)
A-Y: J2.Y (KB_COL_C), U3.16 (A-Y), U4.34 (PA2)
A-Z: J2.Z (KB_ROW_1), U3.17 (A-Z)
BE: U1.10 (BE), U4.5 (BE), U5.5 (BE)
D0: J1.15 (DB0), U1.27 (D0), U4.16 (D0), U5.16 (D0), U6.25 (D0), U12.2 (A0)
D1: J1.14 (DB1), U1.28 (D1), U4.17 (D1), U5.17 (D1), U6.26 (D1), U12.3 (A1)
D2: J1.13 (DB2), U1.29 (D2), U4.18 (D2), U5.18 (D2), U6.27 (D2), U12.4 (A2)
D3: J1.12 (DB3), U1.30 (D3), U4.19 (D3), U5.19 (D3), U6.28 (D3), U12.5 (A3)
D4: J1.11 (DB4), U1.31 (D4), U4.20 (D4), U5.20 (D4), U6.29 (D4), U12.6 (A4)
D5: J1.10 (DB5), U1.32 (D5), U4.21 (D5), U5.21 (D5), U6.30 (D5), U12.7 (A5)
D6: J1.9 (DB6), U1.33 (D6), U4.22 (D6), U5.22 (D6), U6.31 (D6), U12.8 (A6)
D7: J1.8 (DB7), U1.34 (D7), U4.23 (D7), U5.23 (D7), U6.32 (D7), U12.9 (A7)
E-17: J1.17 (SST_OUT), U2.11 (E-17), U3.6 (E-17)
GND: C1.2, C2.2, C3.2, C4.2, C5.2, J1.22 (GND), J2.1 (GND), J3.A12 (GND), J3.B12 (GND), J3.S1 (SHIELD), R50.2, R51.2, R52.2, U1.1 (GND), U2.29 (GND), U3.21 (GND), U4.40 (GND), U5.40 (GND), U6.38 (GND), U7.1 (G1), U7.10 (GND), U7.19 (G2), U7.21 (GND), U10.1 (G1), U10.10 (GND), U10.19 (G2), U10.21 (GND), U11.1 (G1), U11.10 (GND), U11.19 (G2), U11.21 (GND), U12.1 (G1), U12.10 (GND), U12.19 (G2), U12.21 (GND), U13.1 (G1), U13.10 (GND), U13.19 (G2), U13.21 (GND), U14.2 (GND)
K0: J2.B (K0), U2.17 (K0), U6.24 (K0), U7.9 (A7)
K1: J2.C (K1), U2.18 (K1), U6.23 (K1), U7.8 (A6)
K2: J2.D (K2), U2.19 (K2), U6.22 (K2), U7.7 (A5)
K3: J2.E (K3), U2.20 (K3), U6.21 (K3), U7.6 (A4)
K4: J2.F (K4), U2.21 (K4), U6.20 (K4), U7.5 (A3)
K5: J2.H (K5), U2.22 (K5), U4.30 (PB6), U5.30 (PB6), U6.19 (K5), U7.4 (A2)
K6: J1.16 (K6), U2.23 (K6), U5.1 (RSO), U6.18 (K6), U7.3 (A1)
K7: J2.J (K7), U2.24 (K7), U4.1 (RSO), U6.17 (K7), U7.2 (A0)
unnamed: D1.2 (A), R1.2
unnamed: D1.1 (K), U11.11 (Y7)
unnamed: D2.2 (A), R2.2
unnamed: D2.1 (K), U11.12 (Y6)
unnamed: D3.2 (A), R3.2
unnamed: D3.1 (K), U11.13 (Y5)
unnamed: D4.2 (A), R4.2
unnamed: D4.1 (K), U11.14 (Y4)
unnamed: D5.2 (A), R5.2
unnamed: D5.1 (K), U11.15 (Y3)
unnamed: D6.2 (A), R6.2
unnamed: D6.1 (K), U11.16 (Y2)
unnamed: D7.2 (A), R7.2
unnamed: D7.1 (K), U11.17 (Y1)
unnamed: D8.2 (A), R8.2
unnamed: D8.1 (K), U11.18 (Y0)
unnamed: D9.2 (A), R9.2
unnamed: D9.1 (K), U10.11 (Y7)
unnamed: D10.2 (A), R10.2
unnamed: D10.1 (K), U10.12 (Y6)
unnamed: D11.2 (A), R11.2
unnamed: D11.1 (K), U10.13 (Y5)
unnamed: D12.2 (A), R12.2
unnamed: D12.1 (K), U10.14 (Y4)
unnamed: D13.2 (A), R13.2
unnamed: D13.1 (K), U10.15 (Y3)
unnamed: D14.2 (A), R14.2
unnamed: D14.1 (K), U10.16 (Y2)
unnamed: D15.2 (A), R15.2
unnamed: D15.1 (K), U10.17 (Y1)
unnamed: D16.2 (A), R16.2
unnamed: D16.1 (K), U10.18 (Y0)
unnamed: D17.2 (A), R17.2
unnamed: D17.1 (K), U12.11 (Y7)
unnamed: D18.2 (A), R18.2
unnamed: D18.1 (K), U12.12 (Y6)
unnamed: D19.2 (A), R19.2
unnamed: D19.1 (K), U12.13 (Y5)
unnamed: D20.2 (A), R20.2
unnamed: D20.1 (K), U12.14 (Y4)
unnamed: D21.2 (A), R21.2
unnamed: D21.1 (K), U12.15 (Y3)
unnamed: D22.2 (A), R22.2
unnamed: D22.1 (K), U12.16 (Y2)
unnamed: D23.2 (A), R23.2
unnamed: D23.1 (K), U12.17 (Y1)
unnamed: D24.2 (A), R24.2
unnamed: D24.1 (K), U12.18 (Y0)
unnamed: D25.2 (A), R25.2
unnamed: D25.1 (K), U13.11 (Y7)
unnamed: D26.2 (A), R26.2
unnamed: D26.1 (K), U13.12 (Y6)
unnamed: D27.2 (A), R27.2
unnamed: D27.1 (K), U13.13 (Y5)
unnamed: D28.2 (A), R28.2
unnamed: D28.1 (K), U13.14 (Y4)
unnamed: D29.2 (A), R29.2
unnamed: D29.1 (K), U13.15 (Y3)
unnamed: D30.2 (A), R30.2
unnamed: D30.1 (K), U13.16 (Y2)
unnamed: D31.2 (A), R31.2
unnamed: D31.1 (K), U13.17 (Y1)
unnamed: D32.2 (A), R32.2
unnamed: D32.1 (K), U13.18 (Y0)
unnamed: D33.2 (A), R33.2
unnamed: D33.1 (K), U7.11 (Y7)
unnamed: D34.2 (A), R34.2
unnamed: D34.1 (K), U7.12 (Y6)
unnamed: D35.2 (A), R35.2
unnamed: D35.1 (K), U7.13 (Y5)
unnamed: D36.2 (A), R36.2
unnamed: D36.1 (K), U7.14 (Y4)
unnamed: D37.2 (A), R37.2
unnamed: D37.1 (K), U7.15 (Y3)
unnamed: D38.2 (A), R38.2
unnamed: D38.1 (K), U7.16 (Y2)
unnamed: D39.2 (A), R39.2
unnamed: D39.1 (K), U7.17 (Y1)
unnamed: D40.2 (A), R40.2
unnamed: D40.1 (K), U7.18 (Y0)
unnamed: U1.37 (R/~W), U2.5 (R/~W)
unnamed: U1.36 (Φ2), U2.6 (μΦ2)
unnamed: U2.28 (RS), U3.19 (RS)
unnamed: U2.27 (ST), U3.18 (ST)
unnamed: U3.1 (DECA), U4.25 (PB1)
unnamed: U3.2 (DECB), U4.26 (PB2)
unnamed: U3.3 (DECC), U4.27 (PB3)
unnamed: U3.4 (DECD), U4.28 (PB4)
RAM-R/~W: J1.Z (RAM-R/~W), U2.14 (RAM-R/~W), U6.33 (RAM_R/~W), U13.5 (A3)
R/~W: J1.V (R/~W), U2.12 (ΨR/~W), U4.3 (R/~W), U5.3 (R/~W), U6.34 (R/~W), U13.3 (A1)
SYNC: J1.1 (SYNC), U1.38 (~SYNC), U2.4 (SYNC), U13.9 (A7)
VCC: C1.1, C2.1, C3.1, C4.1, C5.1, J1.21 (Vcc), J2.A (Vcc), R1.1, R2.1, R3.1, R4.1, R5.1, R6.1, R7.1, R8.1, R9.1, R10.1, R11.1, R12.1, R13.1, R14.1, R15.1, R16.1, R17.1, R18.1, R19.1, R20.1, R21.1, R22.1, R23.1, R24.1, R25.1, R26.1, R27.1, R28.1, R29.1, R30.1, R31.1, R32.1, R33.1, R34.1, R35.1, R36.1, R37.1, R38.1, R39.1, R40.1, U1.2 (Vcc), U2.30 (Vcc), U3.20 (Vcc), U4.41 (Vcc), U5.41 (Vcc), U6.37 (Vcc), U7.20 (VCC), U10.20 (VCC), U11.20 (VCC), U12.20 (VCC), U13.20 (VCC), U14.1 (Vout)
~IRQ: J1.4 (~IRQ), U1.40 (~IRQ), U2.2 (~IRQ), U13.7 (A5)
~NMI: J1.6 (~NMI), U1.39 (~NMI), U2.3 (~NMI), U3.5 (~NMI), U13.8 (A6)
~RDY: J1.2 (RDY), U1.41 (~RDY), U2.1 (~RDY), U13.6 (A4)
~RST: J1.7 (~RST), U1.35 (~RST), U2.7 (~RST), U4.2 (~RES), U5.2 (~RES)
~R/W: J1.W (~R/W), U2.13 (Ψ~R/W), U6.35 (~R/W), U13.4 (A2)
~Φ2: J1.Y (~Φ2), U2.16 (Ψ~Φ2)
Φ2: J1.U (Φ2), U2.15 (ΨΦ2), U4.4 (Φ2), U5.4 (Φ2), U6.36 (Φ2), U13.2 (A0)

Notes on the sheet:
PWR Switch and 3V Regulator
Bus Watcher
Tape/Teletype
Low Active

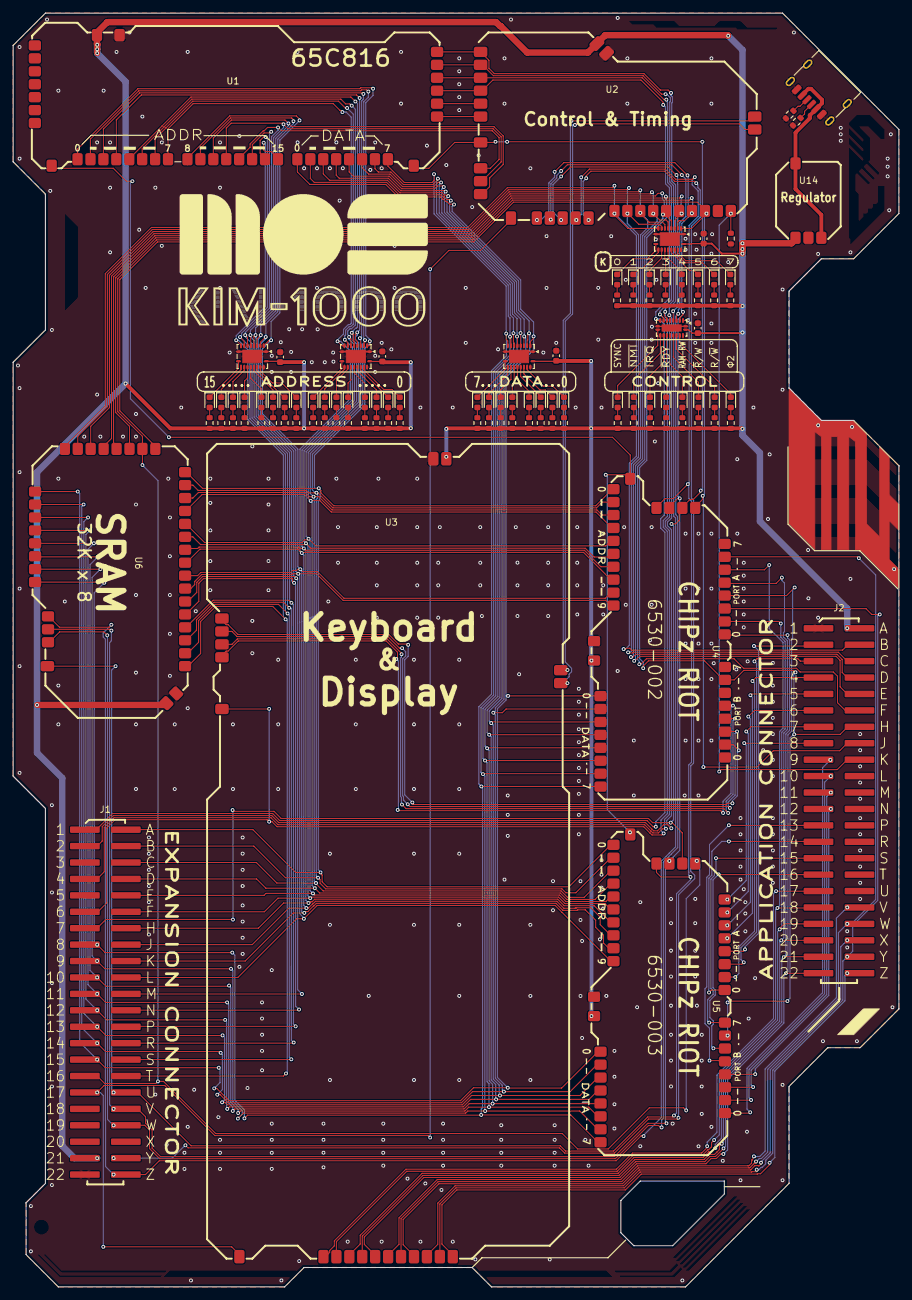
[picture p11: board mainboard.kicad_pcb from above]

Board: 2 copper layers, 137.0 x 197.0 mm, 103 parts (0 on the bottom side), 164 nets.
