CircuitMonkey/mos-kim1-replica/pcb/kbd-display-module/kbd-display-module.kicad_pcb

## KiCad design pcb/kbd-display-module/kbd-display-module.kicad_pcb (2025-08-19)

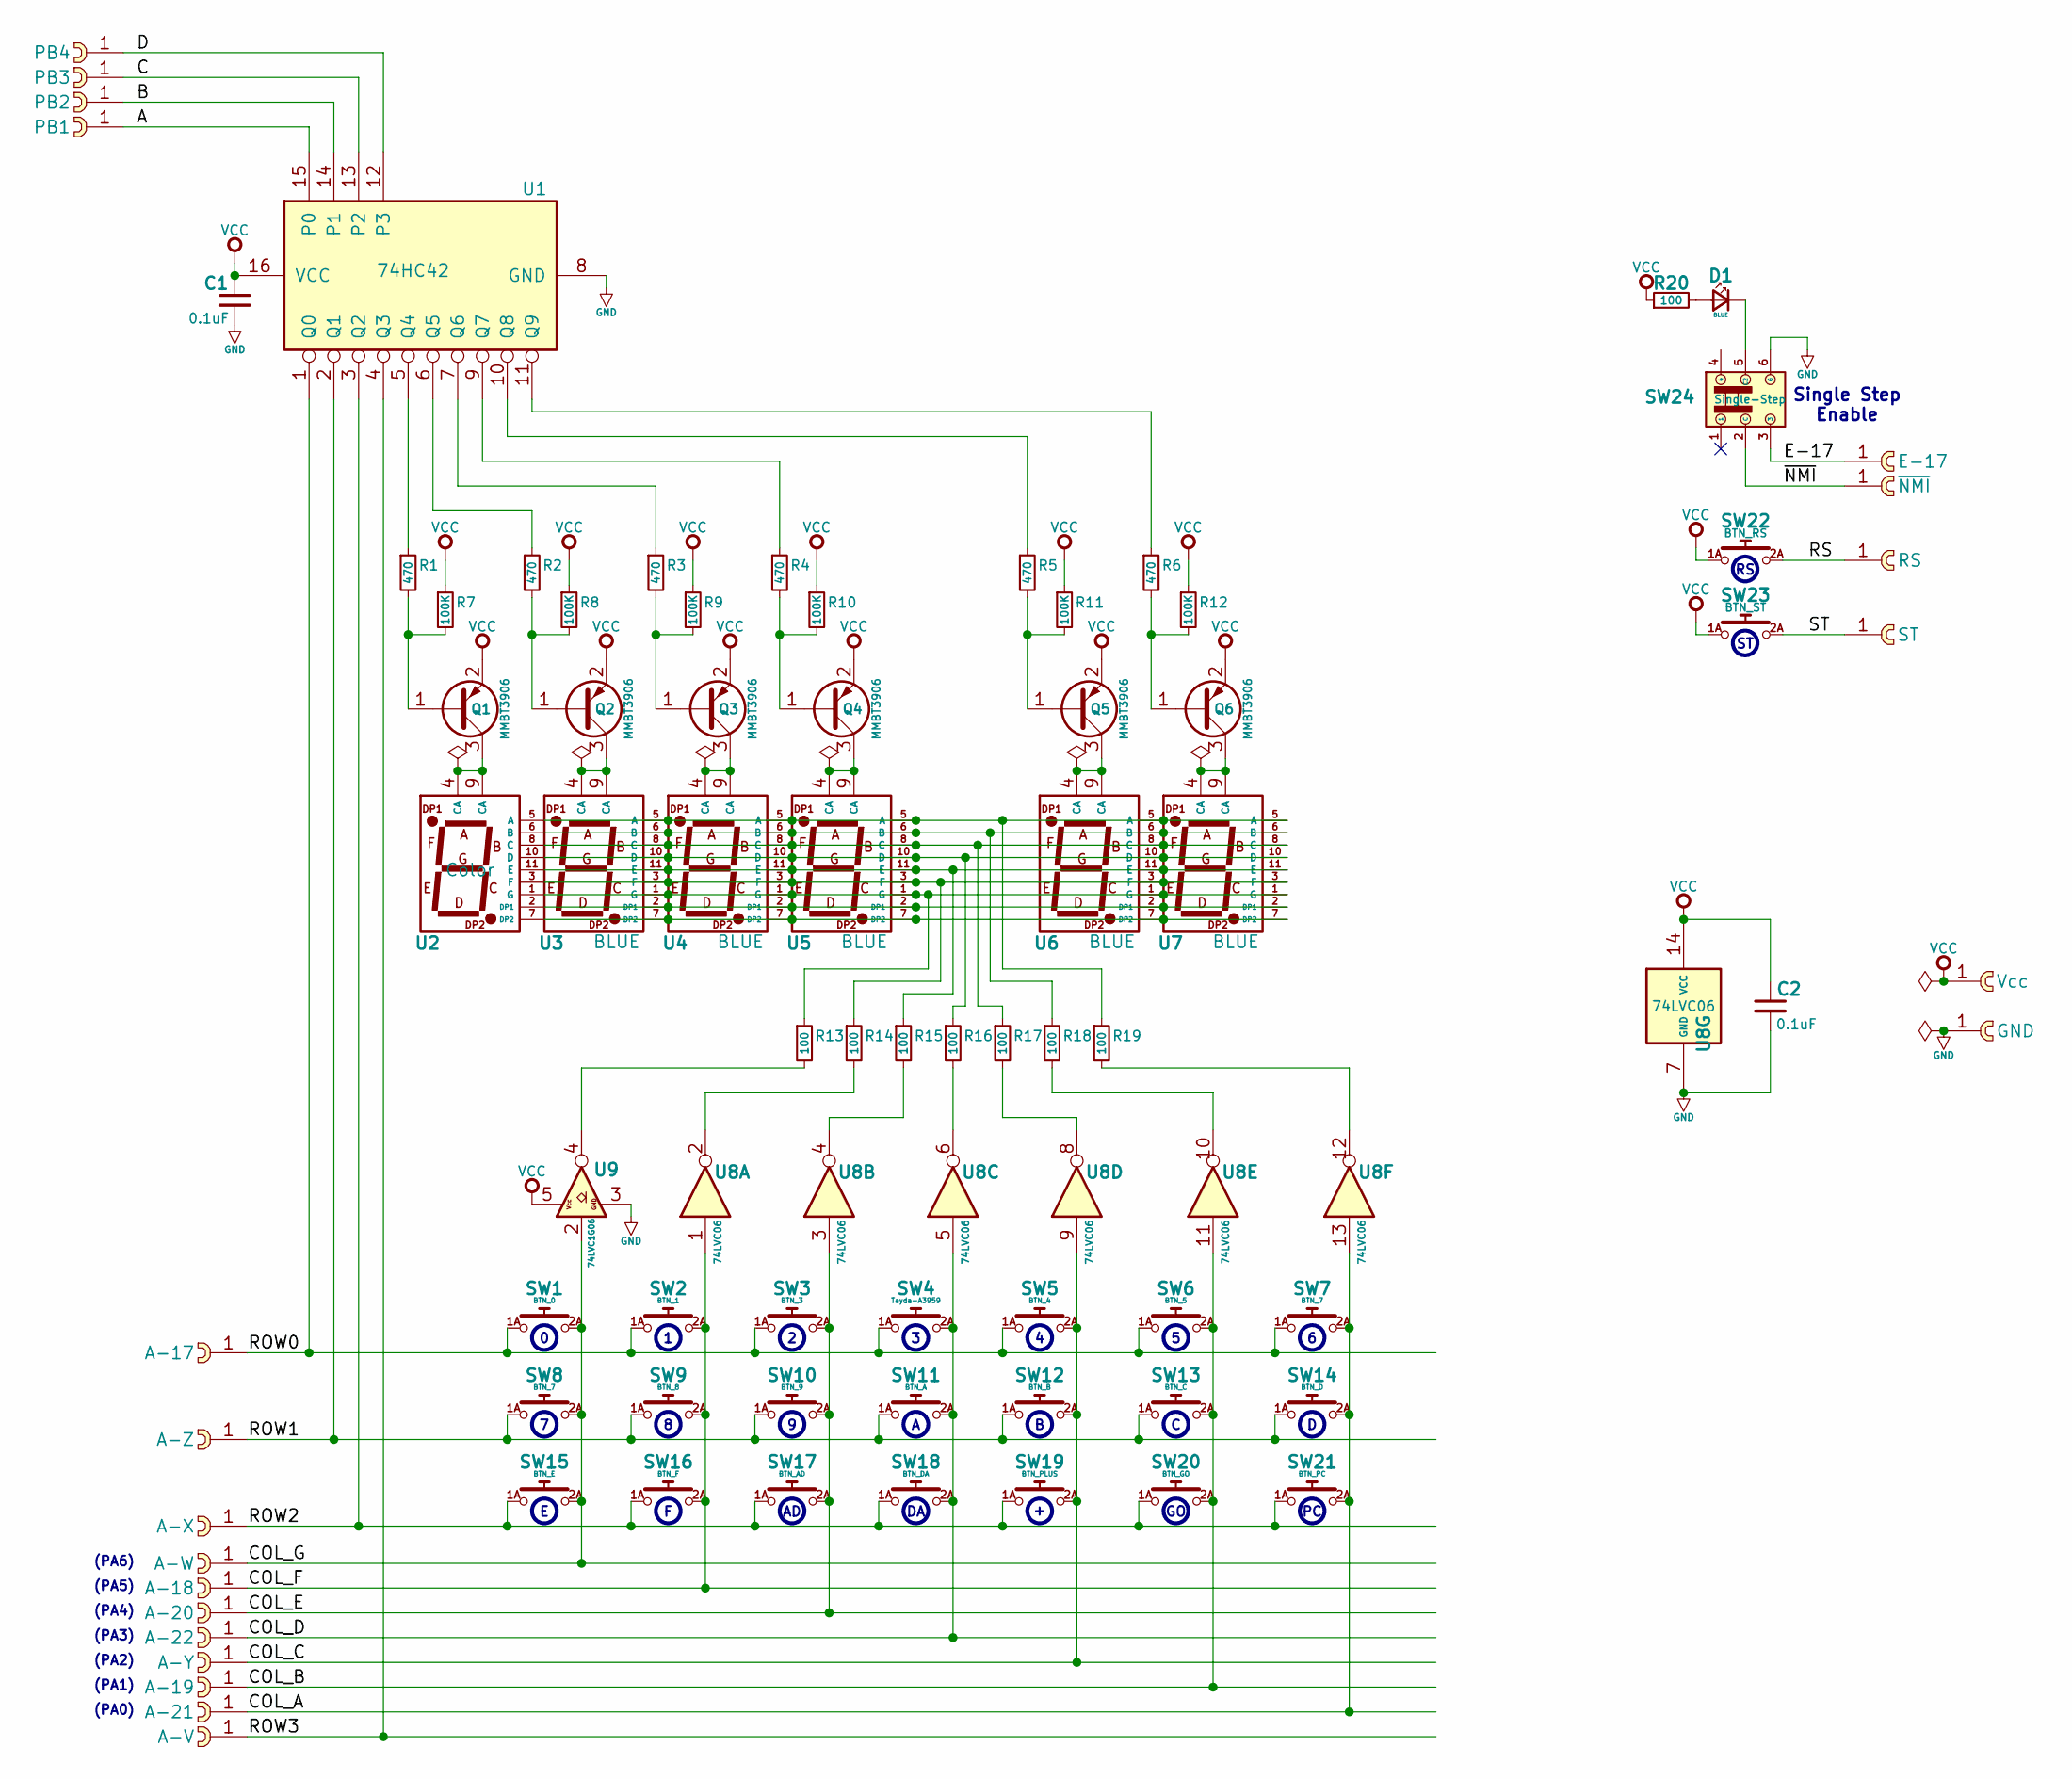
[picture p12: schematic kbd-display-module.kicad_sch, Kim-1 Replica - Keyboard & Display CHIPz Module]

Parts:
C1, C2: 0.1uF; C_0603_1608Metric
CST1: PB4; cast-2.0-01P
CST2: PB3; cast-2.0-01P
CST3: PB2; cast-2.0-01P
CST4: PB1; cast-2.0-01P
CST5: E-17; cast-2.0-01P
CST6: ~{NMI}; cast-2.0-01P
CST7: RS; cast-2.0-01P
CST8: ST; cast-2.0-01P
CST9: Vcc; cast-2.0-01P
CST10: GND; cast-2.0-01P
CST11: A-17; cast-2.0-01P
CST12: A-Z; cast-2.0-01P
CST13: A-X; cast-2.0-01P
CST14: A-W; cast-2.0-01P
CST15: A-18; cast-2.0-01P
CST16: A-20; cast-2.0-01P
CST17: A-22; cast-2.0-01P
CST18: A-Y; cast-2.0-01P
CST19: A-19; cast-2.0-01P
CST20: A-21; cast-2.0-01P
CST21: A-V; cast-2.0-01P
D1: BLUE; LED_0603_1608Metric
Q1, Q2, Q3, Q4, Q5, Q6: MMBT3906; SOT-23
R1, R2, R3, R4, R5, R6: 470; R_0603_1608Metric
R7, R8, R9, R10, R11, R12: 100K; R_0603_1608Metric
R13, R14, R15, R16, R17, R18, R19, R20: 100; R_0603_1608Metric
SW1: BTN_0; Tactile_CK_KSC_6x6_Gullwing
SW2: BTN_1; Tactile_CK_KSC_6x6_Gullwing
SW3: BTN_3; Tactile_CK_KSC_6x6_Gullwing
SW4: Tayda-A3959; Tactile_CK_KSC_6x6_Gullwing
SW5: BTN_4; Tactile_CK_KSC_6x6_Gullwing
SW6: BTN_5; Tactile_CK_KSC_6x6_Gullwing
SW7, SW8: BTN_7; Tactile_CK_KSC_6x6_Gullwing
SW9: BTN_8; Tactile_CK_KSC_6x6_Gullwing
SW10: BTN_9; Tactile_CK_KSC_6x6_Gullwing
SW11: BTN_A; Tactile_CK_KSC_6x6_Gullwing
SW12: BTN_B; Tactile_CK_KSC_6x6_Gullwing
SW13: BTN_C; Tactile_CK_KSC_6x6_Gullwing
SW14: BTN_D; Tactile_CK_KSC_6x6_Gullwing
SW15: BTN_E; Tactile_CK_KSC_6x6_Gullwing
SW16: BTN_F; Tactile_CK_KSC_6x6_Gullwing
SW17: BTN_AD; Tactile_CK_KSC_6x6_Gullwing
SW18: BTN_DA; Tactile_CK_KSC_6x6_Gullwing
SW19: BTN_PLUS; Tactile_CK_KSC_6x6_Gullwing
SW20: BTN_GO; Tactile_CK_KSC_6x6_Gullwing
SW21: BTN_PC; Tactile_CK_KSC_6x6_Gullwing
SW22: BTN_RS; Tactile_CK_KSC_6x6_Gullwing
SW23: BTN_ST; Tactile_CK_KSC_6x6_Gullwing
SW24: Single-Step; CK_JS202011SC_SLIDE_DPDT_SMT_9x3.6; MPN CK JS202011SC
U1: 74HC42; SO-16_3.9x9.9mm_P1.27mm
U2: Color; Avago-HDSM-281x-283x-SevenSeg; MPN Avago HDSM-281B
U3, U4, U5, U6, U7: BLUE; Avago-HDSM-281x-283x-SevenSeg; MPN Avago HDSM-281B
U8: 74LVC06; SOIC-14_3.9x8.7mm_P1.27mm
U9: 74LVC1G06; SOT-553

Connections:
/COL_A: CST20.1, SW7.2A, SW7.2B, SW14.2A, SW14.2B, SW21.2A, SW21.2B, U8.13
/COL_B: CST19.1, SW6.2A, SW6.2B, SW13.2A, SW13.2B, SW20.2A, SW20.2B, U8.11
/COL_C: CST18.1, SW5.2A, SW5.2B, SW12.2A, SW12.2B, SW19.2A, SW19.2B, U8.9
/COL_D: CST17.1, SW4.2A, SW4.2B, SW11.2A, SW11.2B, SW18.2A, SW18.2B, U8.5
/COL_E: CST16.1, SW3.2A, SW3.2B, SW10.2A, SW10.2B, SW17.2A, SW17.2B, U8.3
/COL_F: CST15.1, SW2.2A, SW2.2B, SW9.2A, SW9.2B, SW16.2A, SW16.2B, U8.1
/COL_G: CST14.1, SW1.2A, SW1.2B, SW8.2A, SW8.2B, SW15.2A, SW15.2B, U9.2
/E-17: CST5.1, SW24.3
/ROW0: CST11.1, SW1.1A, SW1.1B, SW2.1A, SW2.1B, SW3.1A, SW3.1B, SW4.1A, SW4.1B, SW5.1A, SW5.1B, SW6.1A, SW6.1B, SW7.1A, SW7.1B, U1.1 (Q0)
/ROW1: CST12.1, SW8.1A, SW8.1B, SW9.1A, SW9.1B, SW10.1A, SW10.1B, SW11.1A, SW11.1B, SW12.1A, SW12.1B, SW13.1A, SW13.1B, SW14.1A, SW14.1B, U1.2 (Q1)
/ROW2: CST13.1, SW15.1A, SW15.1B, SW16.1A, SW16.1B, SW17.1A, SW17.1B, SW18.1A, SW18.1B, SW19.1A, SW19.1B, SW20.1A, SW20.1B, SW21.1A, SW21.1B, U1.3 (Q2)
/ROW3: CST21.1, U1.4 (Q3)
/RS: CST7.1, SW22.2A, SW22.2B
/ST: CST8.1, SW23.2A, SW23.2B
/~NMI: CST6.1, SW24.2 (C)
GND: C1.2, C2.2, CST10.1, SW24.6, U1.8 (GND), U8.7 (GND), U9.3
unnamed: D1.2 (A), R20.2
unnamed: D1.1 (K), SW24.5 (C2)
unnamed: Q1.1 (B), R1.2, R7.2
unnamed: Q1.3 (C), U2.4 (CA), U2.9 (CA)
unnamed: Q2.1 (B), R2.2, R8.2
unnamed: Q2.3 (C), U3.4 (CA), U3.9 (CA)
unnamed: Q3.1 (B), R3.2, R9.2
unnamed: Q3.3 (C), U4.4 (CA), U4.9 (CA)
unnamed: Q4.1 (B), R4.2, R10.2
unnamed: Q4.3 (C), U5.4 (CA), U5.9 (CA)
unnamed: Q5.1 (B), R5.2, R11.2
unnamed: Q5.3 (C), U6.4 (CA), U6.9 (CA)
unnamed: Q6.1 (B), R6.2, R12.2
unnamed: Q6.3 (C), U7.4 (CA), U7.9 (CA)
unnamed: R13.2, U9.4
unnamed: R14.2, U8.2
unnamed: R15.2, U8.4
unnamed: R16.2, U8.6
unnamed: R17.2, U8.8
unnamed: R18.2, U8.10
unnamed: R19.2, U8.12
unnamed: CST4.1, U1.15 (P0)
unnamed: CST3.1, U1.14 (P1)
unnamed: CST2.1, U1.13 (P2)
unnamed: CST1.1, U1.12 (P3)
unnamed: R1.1, U1.5 (Q4)
unnamed: R2.1, U1.6 (Q5)
unnamed: R3.1, U1.7 (Q6)
unnamed: R4.1, U1.9 (Q7)
unnamed: R5.1, U1.10 (Q8)
unnamed: R6.1, U1.11 (Q9)
unnamed: R19.1, U2.5 (A), U3.5 (A), U4.5 (A), U5.5 (A), U6.5 (A), U7.5 (A)
unnamed: R18.1, U2.6 (B), U3.6 (B), U4.6 (B), U5.6 (B), U6.6 (B), U7.6 (B)
unnamed: R17.1, U2.8 (C), U3.8 (C), U4.8 (C), U5.8 (C), U6.8 (C), U7.8 (C)
unnamed: R16.1, U2.10 (D), U3.10 (D), U4.10 (D), U5.10 (D), U6.10 (D), U7.10 (D)
unnamed: U2.2 (DP1), U3.2 (DP1), U4.2 (DP1), U5.2 (DP1), U6.2 (DP1), U7.2 (DP1)
unnamed: U2.7 (DP2), U3.7 (DP2), U4.7 (DP2), U5.7 (DP2), U6.7 (DP2), U7.7 (DP2)
unnamed: R15.1, U2.11 (E), U3.11 (E), U4.11 (E), U5.11 (E), U6.11 (E), U7.11 (E)
unnamed: R14.1, U2.3 (F), U3.3 (F), U4.3 (F), U5.3 (F), U6.3 (F), U7.3 (F)
unnamed: R13.1, U2.1 (G), U3.1 (G), U4.1 (G), U5.1 (G), U6.1 (G), U7.1 (G)
VCC: C1.1, C2.1, CST9.1, Q1.2 (E), Q2.2 (E), Q3.2 (E), Q4.2 (E), Q5.2 (E), Q6.2 (E), R7.1, R8.1, R9.1, R10.1, R11.1, R12.1, R20.1, SW22.1A, SW22.1B, SW23.1A, SW23.1B, U1.16 (VCC), U8.14 (VCC), U9.5

Notes on the sheet:
Single Step Enable
(PA1)
(PA0)
(PA6)
(PA3)
(PA2)
(PA4)
(PA5)

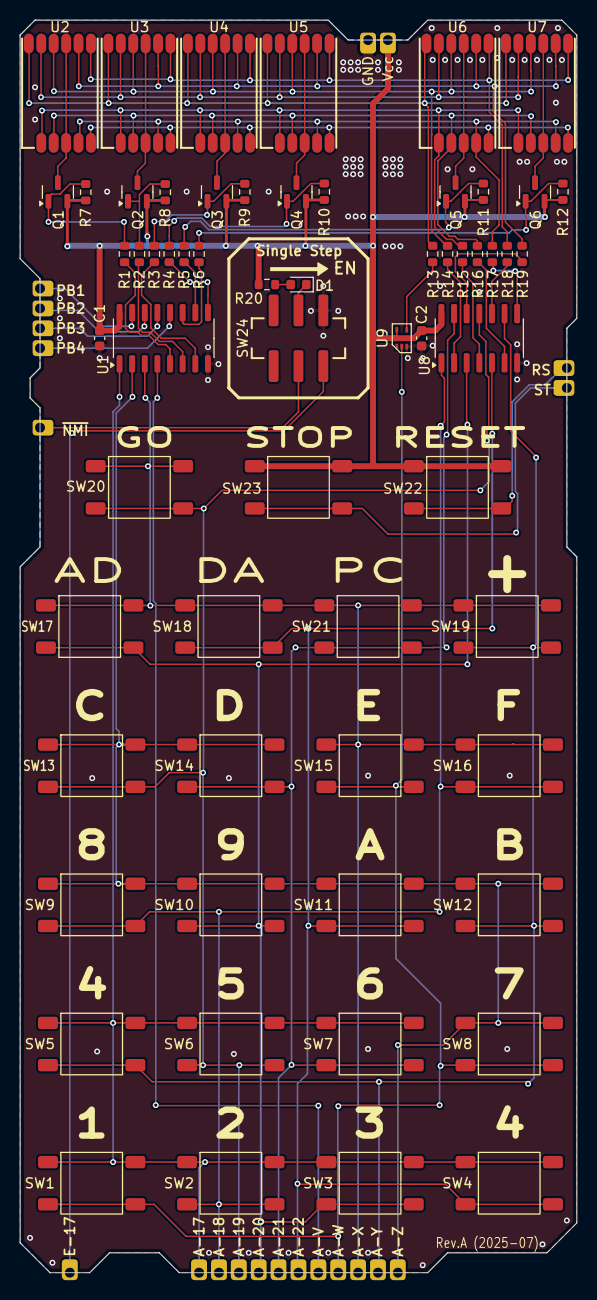
[picture p13: board kbd-display-module.kicad_pcb from above]

Board: 2 copper layers, 56.0 x 126.0 mm, 83 parts (0 on the bottom side), 57 nets.
