CircuitMonkey/mos-kim1-replica/pcb/sram-32kx8-module/sram-32kx8-module.kicad_pcb

## KiCad design pcb/sram-32kx8-module/sram-32kx8-module.kicad_pcb (2025-07-25)

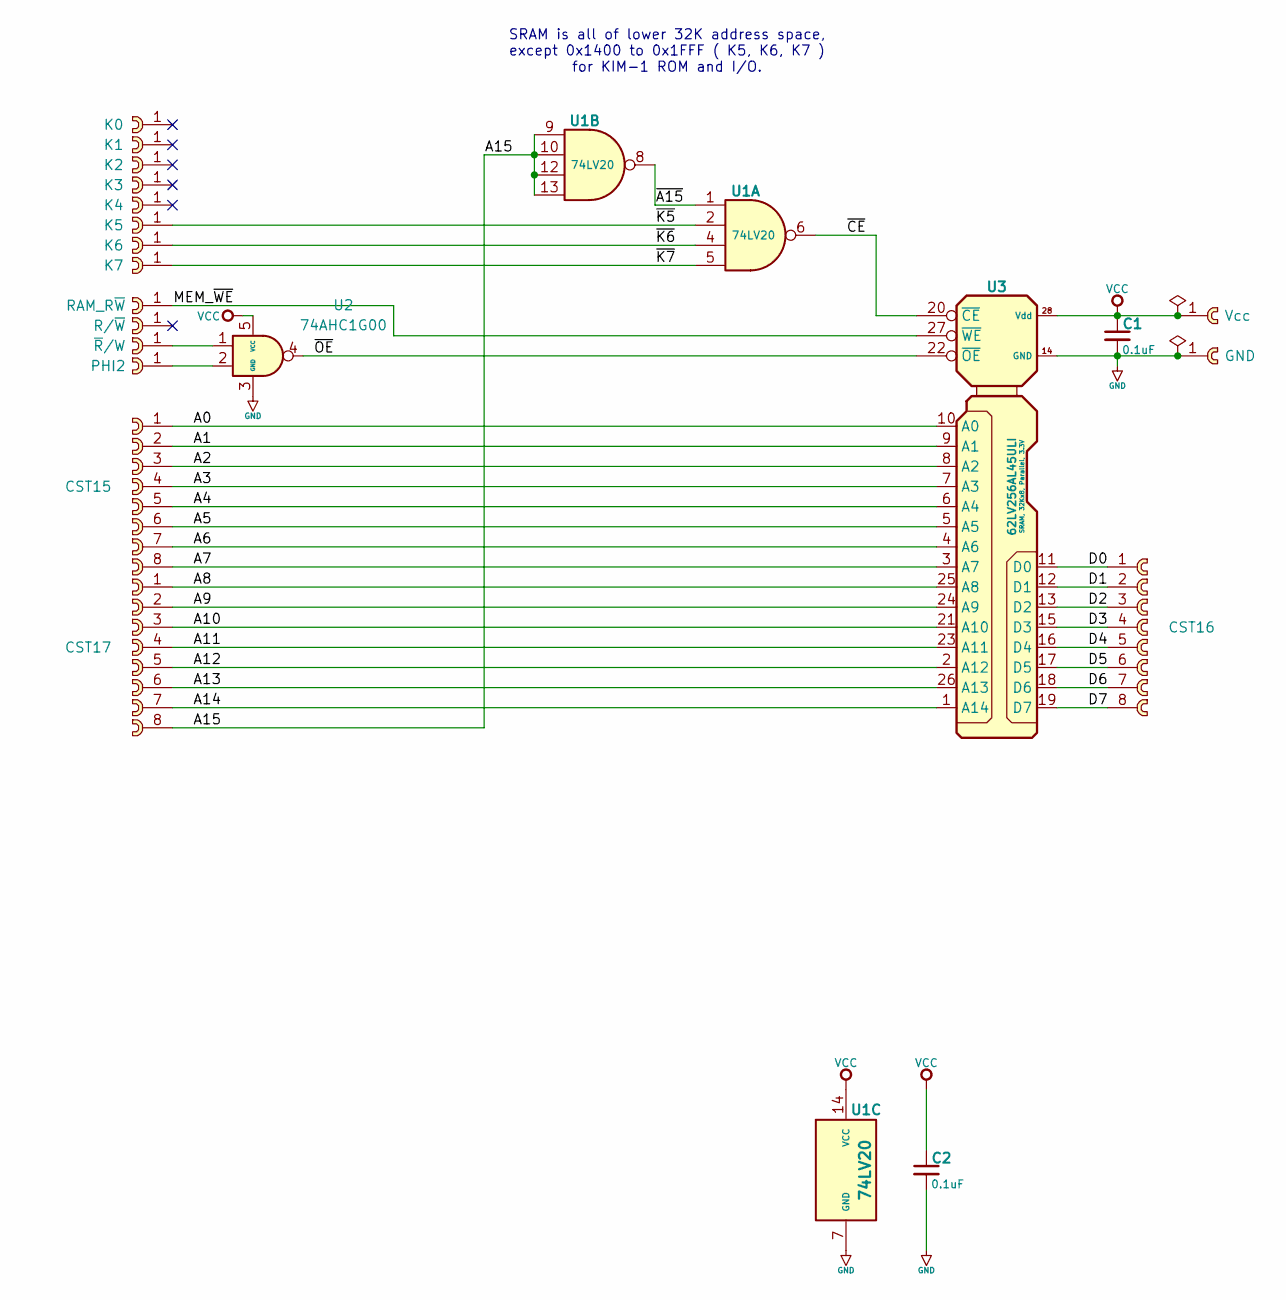
[picture p14: schematic sram-32kx8-module.kicad_sch, SRAM Module, 32Kx8, for KIM-1]

Parts:
C1, C2: 0.1uF; C_0603_1608Metric
CST1: K0; cast-2.0-01P
CST2: K1; cast-2.0-01P
CST3: K2; cast-2.0-01P
CST4: K3; cast-2.0-01P
CST5: K4; cast-2.0-01P
CST6: K5; cast-2.0-01P
CST7: K6; cast-2.0-01P
CST8: K7; cast-2.0-01P
CST9: RAM_R~{W}; cast-2.0-01P
CST10: Vcc; cast-2.0-01P
CST11: R/~{W}; cast-2.0-01P
CST12: ~{R}/W; cast-2.0-01P
CST13: GND; cast-2.0-01P
CST14: PHI2; cast-2.0-01P
CST15, CST16, CST17: DATA I/O; cast-2.0-08P
U1: 74LV20; SOIC-14_3.9x8.7mm_P1.27mm
U2: 74AHC1G00; SOT-353_SC-70-5; MPN MC74HC1G00DFT1G
U3: 62LV256AL45ULI; SOIC-28_18x9

Connections:
/A0: CST15.1, U3.10 (A0)
/A1: CST15.2, U3.9 (A1)
/A2: CST15.3, U3.8 (A2)
/A3: CST15.4, U3.7 (A3)
/A4: CST15.5, U3.6 (A4)
/A5: CST15.6, U3.5 (A5)
/A6: CST15.7, U3.4 (A6)
/A7: CST15.8, U3.3 (A7)
/A8: CST17.1, U3.25 (A8)
/A9: CST17.2, U3.24 (A9)
/A10: CST17.3, U3.21 (A10)
/A11: CST17.4, U3.23 (A11)
/A12: CST17.5, U3.2 (A12)
/A13: CST17.6, U3.26 (A13)
/A14: CST17.7, U3.1 (A14)
/A15: CST17.8, U1.9, U1.10, U1.12, U1.13
/D0: CST16.1, U3.11 (D0)
/D1: CST16.2, U3.12 (D1)
/D2: CST16.3, U3.13 (D2)
/D3: CST16.4, U3.15 (D3)
/D4: CST16.5, U3.16 (D4)
/D5: CST16.6, U3.17 (D5)
/D6: CST16.7, U3.18 (D6)
/D7: CST16.8, U3.19 (D7)
/MEM_~WE: CST9.1, U3.27 (~WE)
/~A15: U1.1, U1.8
/~CE: U1.6, U3.20 (~CE)
/~K5: CST6.1, U1.2
/~K6: CST7.1, U1.4
/~K7: CST8.1, U1.5
/~OE: U2.4, U3.22 (~OE)
GND: C1.2, C2.2, CST13.1, U1.7 (GND), U2.3 (GND), U3.14 (GND)
unnamed: CST12.1, U2.1
unnamed: CST14.1, U2.2
VCC: C1.1, C2.1, CST10.1, U1.14 (VCC), U2.5 (VCC), U3.28 (Vdd)

Notes on the sheet:
SRAM is all of lower 32K address space, except 0x1400 to 0x1FFF ( K5, K6, K7 ) for KIM-1 ROM and I/O.

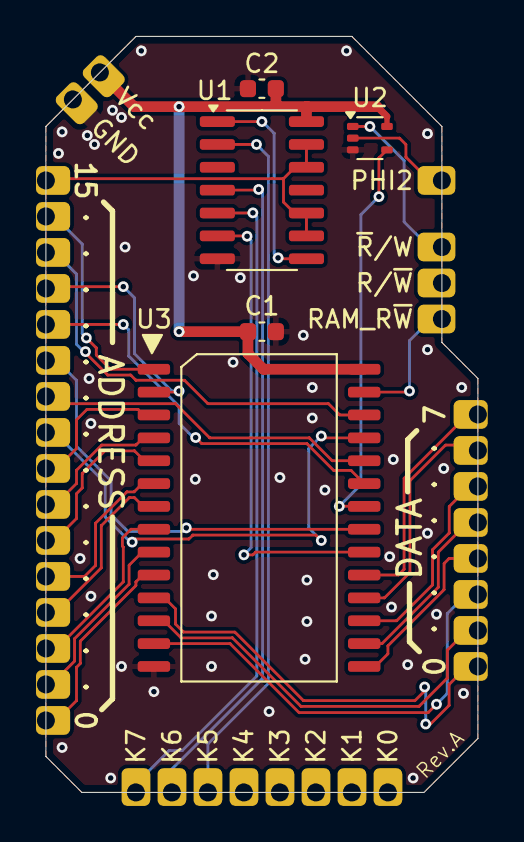
[picture p15: board sram-32kx8-module.kicad_pcb from above]

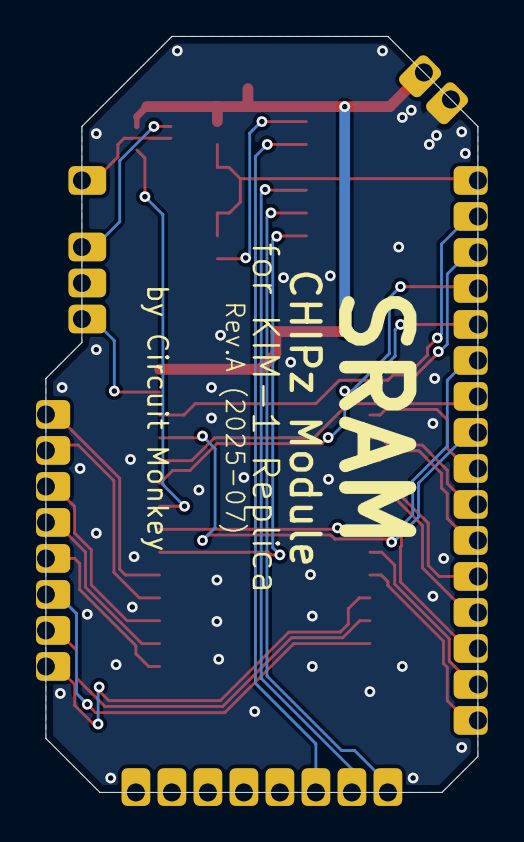
[picture p16: board sram-32kx8-module.kicad_pcb from below]

Board: 2 copper layers, 24.0 x 42.0 mm, 22 parts (2 on the bottom side), 35 nets.
