CircuitMonkey/mos-kim1-replica/(commit log)

2025-07-20 RevA Sent to Fab.
    [control-logic-module.kicad_pcb, control-logic-module.kicad_sch]
2025-07-23 Created Rev.A for Keyboard-Display Module
    [kbd-display-module.kicad_pcb, kbd-display-module.kicad_sch]
2025-07-25 Created SRAM module, Rev.A
    [sram-32kx8-module.kicad_pcb, sram-32kx8-module.kicad_sch]
2025-07-27 Fix ERC Errors
    [control-logic-module.kicad_sch]
2025-07-27 3D model for SRAM CHIPz Module
    [sram-32kx8-module.step]
2025-08-05 Tune Keyboard module design.
    [kbd-display-module.kicad_sch]
2025-08-05 Rev-A of KIM-1 Replica. Final???
    [mainboard.kicad_pcb, mainboard.kicad_sch]
2025-08-05 Add 3Dmodel for 22x2 connector.
2025-08-05 Add 3D for USB and expansion connectors.
    [mainboard.kicad_pcb]
2025-08-19 Minore changes.
    [sram-32kx8-module.kicad_sch]
2025-08-19 Add MPN for component.
    [kbd-display-module.kicad_pcb]
2025-08-19 Add Note regarding component cost.
    [kbd-display-module.kicad_sch]
2025-08-19 Add BOMs
    [control-logic-module-bom.ods, kbd-display-module-bom.ods, sram-32kx8-module-bom.ods]
2025-08-31 Added assembly notes for future changes.
    [control-logic-module.kicad_sch, kbd-display-module.kicad_sch]
2025-09-02 Add design note to schematic.
    [sram-32kx8-module.kicad_sch]
2025-09-02 Print schematic to PDF.
2025-09-03 Add PDF schematic for control module.
2025-09-03 Make some corrections. Bump Rev to B.
    [control-logic-module.kicad_pcb, control-logic-module.kicad_sch]
2025-09-07 Add rework note.
    [sram-32kx8-module.kicad_sch]
2025-09-09 Final tuning.
    [mainboard.kicad_pcb, mainboard.kicad_sch]
2025-09-09 Fix paste mask issue with SRAM component.
    [mainboard.kicad_pcb]
2025-09-09 Add gerber setting.
2025-09-10 Gerbers for PCB as ordered on 9-SEP-2025
2025-09-10 Move gerber zip file.
2025-09-22 Update and finalize rev-b board.
    [control-logic-module.kicad_pcb, control-logic-module.kicad_sch]
2025-11-04 Fix chip reference. Was wrong part number provided.
    [mainboard.kicad_sch]
2025-11-04 Add changes for Rev.C. Clock pin connection issue.
    [control-logic-module.kicad_sch]
